lucklyduck/nailongBotWiki/source/docs/01-intro/01-specs.md

---
slug: /intro/specs
title: 规格参数
sidebar_label: 规格参数
---

import Electronics from '../_partials/materials-electronics.mdx';
import PrintedParts from '../_partials/materials-printed-parts.mdx';
import ServoAccessories from '../_partials/materials-servo-accessories.mdx';
import Tools from '../_partials/materials-tools.mdx';

## 1. 电子件

<Electronics />

## 2. 打印件

<PrintedParts />

## 3. 舵机配件

<ServoAccessories />

## 4. 工具

<Tools />
