lucklyduck/nailongBotWiki/source/README.md

# 奶龙机器人 Wiki 源码

用 Docusaurus 3 写成。打包说明和待确认清单见上一级目录的 README.md。

```bash
npm install
npm run start   # 边改边看
npm run build   # 正式构建，结果在 build/
./preview.sh    # 预览构建结果
```
