lucklyduck/nailongBotWiki/source/docs/all-docs.mdx

---
title: 全部文档
slug: /all-docs
hide_table_of_contents: true
sidebar_class_name: sidebar-hidden
sidebar_position: 100
---

import AllDocs from '@site/src/components/AllDocs';

<AllDocs />
