lucklyduck/nailongBotWiki/source/docs/01-intro/03-status.md

---
slug: /intro/status
title: 功能状态
sidebar_label: 功能状态
---

## 1. 功能适配表

✅ 支持　⚠️ 部分支持 / 有条件　❌ 不支持　— 不涉及

| 功能 | 官方 Otto 固件 v2.5.3 | 奶龙固件 2.0.16 | 说明 |
|---|---|---|---|
| 语音唤醒 | ✅ 你好小智 | ✅ 你好奶龙 | 奶龙唤醒词阈值 20%，识别率需实机调 |
| 按键对话 | ✅ | ✅ | 奶龙固件：待机时按一下进入对话，对话中按一下退出 |
| xiaozhi.me 对话 | ✅ | ✅ | |
| 屏幕表情 | ✅ 21 个 | ✅ 21 个看山表情 | 表情名称相同 |
| 动作贴图 | ❌ | ✅ | 动作时临时显示对应动作图 |
| 走路 / 转身 / 跳 / 摇摆 / 太空步 / 弯腰 / 抖腿 / 上下 | ✅ | ✅ | |
| 手臂动作 | ✅ 需装手臂 | ❌ | 奶龙不装手臂 |
| 奶龙大笑音效 `self.otto.laugh` | ❌ | ✅ | 本地播放约 2 秒笑声 |
| 舵机校准（语音） | ✅ | ✅ | `set_trim` / `get_trims` |
| 微信小程序控制 / 校准 | ✅（≥ v2.0.4-2） | ⚠️ 未验证 | |
| 网页在线烧录 | ✅ | ❌ | 奶龙固件需要自己编译 |
| 本地 Otto Master（局域网 MQTT / WebSocket） | ❌ | ✅ | 进阶，见 [本地联调](/docs/debug/otto-master) |
| 摄像头 | ⚠️ 摄像头版硬件 | ❌ | 奶龙外壳没有摄像头位置 |

## 2. 怎么选

- 只想尽快让它动起来：用 **官方固件**，[网页在线烧录](/docs/flash/online) 5 分钟搞定，然后换成奶龙人设也能聊。
- 想要「你好奶龙」唤醒、看山表情和奶龙大笑，或者打算改代码：用 **奶龙固件**，见 [编译奶龙固件](/docs/flash/build)。
