lucklyduck/nailongBotWiki/source/docs/05-xiaozhi/01-login.md

---
slug: /xiaozhi/login
title: 注册登录
sidebar_label: 注册登录
---

## 1. 登录

1. 用电脑或手机浏览器打开 [xiaozhi.me](https://xiaozhi.me/)。
2. 点击进入 **控制台**。
3. 用手机号和短信验证码登录。第一次登录会自动注册。

**会看到什么**：登录后进入控制台，首页是「智能体」列表。新账号会有一个默认智能体，或者需要先点「创建智能体」建一个。

## 2. 智能体是什么

**智能体**就是一个「角色」：它有自己的名字、人设、声音和大模型。一个智能体下可以绑定多台机器人，它们会共用同一套人设。

建议给奶龙单独建一个智能体，取名「奶龙」，之后在 [配置奶龙人设](/docs/xiaozhi/role) 里设置。

:::tip
有多只样机（比如奶龙和看山）时，可以建两个智能体，一个叫「奶龙」一个叫「看山」，分别绑定，就能有两种性格。
:::
