lucklyduck/nailongBotWiki/source/docs/05-xiaozhi/index.md

---
slug: /xiaozhi
title: xiaozhi 后台
sidebar_label: xiaozhi 后台
---

## 1. 简介

[xiaozhi.me](https://xiaozhi.me/) 是小智 AI 的官方后台。奶龙机器人自己只负责「听、说、动」，听懂你的话、按人设想好怎么回答、合成语音，都在这个后台完成。

在后台里你可以：

- 把机器人绑定到自己的账号
- 设置角色人设（让它说话像奶龙）
- 选择大模型、声音、对话语言
- 接入云端 MCP，给奶龙加新本领（查天气、控制智能家居等）

改完设置后**不用重新烧录**，重启机器人或者下一次对话就生效。

| 步骤 | 页面 |
|---|---|
| 1 | [注册登录](/docs/xiaozhi/login) |
| 2 | [绑定设备](/docs/xiaozhi/bind) |
| 3 | [配置奶龙人设](/docs/xiaozhi/role) |
| 进阶 | [接入云端 MCP](/docs/xiaozhi/mcp) |

:::info
xiaozhi.me 的界面会更新，本章的菜单名称以写作时（2026-10）为准。找不到某个按钮时，按意思在页面上找相近的入口。
:::

:::info 待补充
本章各步骤的后台真实截图。
:::

## 2. 机器人怎么找到后台

奶龙固件和官方固件开机后都会访问默认的 OTA 地址 `https://api.tenclass.net/xiaozhi/ota/`，这是 xiaozhi.me 的服务。后台会告诉机器人：该连哪个服务器、有没有新固件、有没有绑定账号。所以**不需要在机器人上做任何服务器设置**，配好网就能连上。

想换成自己搭的服务器，见 [更换服务端](/docs/dev/server)。
