lucklyduck/nailongBotWiki/source/docs/08-download/02-contact.md

---
slug: /download/contact
title: 联系与反馈
sidebar_label: 联系与反馈
---

## 1. 奶龙机器人

奶龙机器人由 **知造 ZhiForge**（catnipent 团队）在 2026 知乎黑客松 · 校园新锐季上制作。ZhiForge 想做的事是：把知乎上的硬件灵感、三维预览、代码生成和实机烧录接成一条线，让普通人「一句话 + 一根数据线」就能做出自己的 AI 硬件伙伴。奶龙就是这条线上做出来的第一只。

<figure>
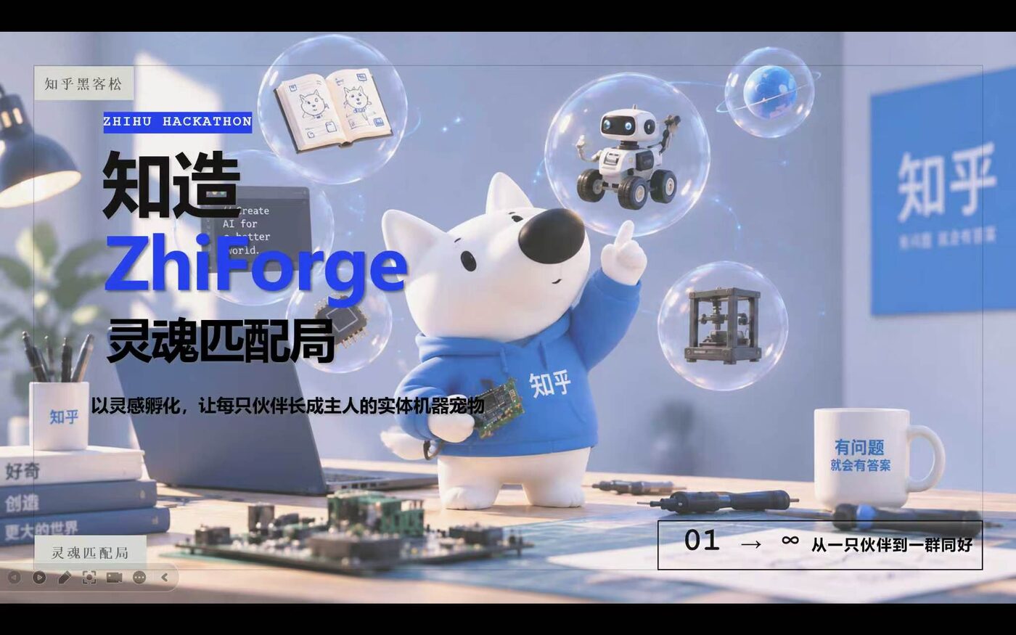
[picture p9: source/static/img/photos/zhiforge-cover.jpg]
知造 ZhiForge 灵魂匹配局的封面图：刘看山穿着知乎卫衣站在工作台前，周围漂浮着书本、机器人和 3D 打印机的气泡
  
  <figcaption>知造 ZhiForge · 灵魂匹配局</figcaption>
</figure>

<figure>
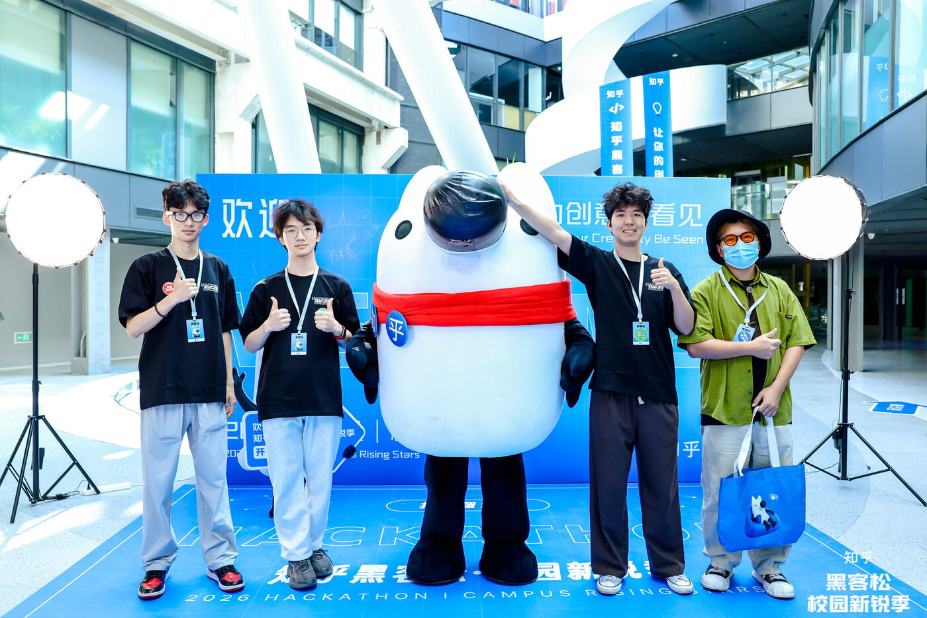
[picture p10: source/static/img/photos/team.jpg]
catnipent 团队成员和刘看山吉祥物在 2026 知乎黑客松背景板前合影
  
  <figcaption>catnipent 团队与刘看山</figcaption>
</figure>

<figure>
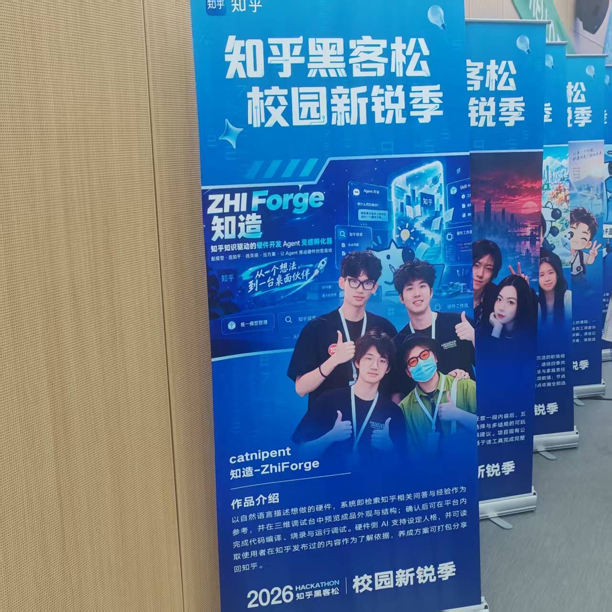
[picture p11: source/static/img/photos/rollup.jpg]
黑客松现场的易拉宝展架，写着知造 ZhiForge、catnipent 团队和作品介绍
  
  <figcaption>黑客松现场的作品展架</figcaption>
</figure>

:::info 待补充
团队的联系方式（知乎账号、邮箱或交流群）。
:::

## 2. Otto 社区

| 渠道 | 地址 |
|---|---|
| 立创开源工程（评论区） | [oshwhub.com/txp666/ottorobot](https://oshwhub.com/txp666/ottorobot) |
| Otto 复刻交流 QQ 群 | 1046432896 |
| Otto 官方文档 | [ottodiy.tech](https://ottodiy.tech/) |
| 闪猫侠官网 | [shanmaotech.cn](https://www.shanmaotech.cn/) |

## 3. 小智 AI

| 渠道 | 地址 |
|---|---|
| 源码与 Issues | [github.com/78/xiaozhi-esp32](https://github.com/78/xiaozhi-esp32) |
| 后台 | [xiaozhi.me](https://xiaozhi.me/) |

## 4. 反馈 wiki 的问题

发现步骤写错、链接失效，或者你照着做成功了想分享照片，都欢迎反馈。提问时附上：

1. 用的是官方固件还是奶龙固件，版本号
2. 卡在哪一页的哪一步
3. 串口日志（见 [看串口日志](/docs/debug/serial)）
