lucklyduck/nailongBotWiki/source/docs/08-download/03-share.md

---
slug: /download/share
title: 晒出你的奶龙
sidebar_label: 晒出你的奶龙
---

## 1. 为什么要晒

ZhiForge 想做的事情之一，就是让做出来的东西不止停在自己桌上。你从知乎上找到的灵感、踩过的坑，写出来就能变成下一个人的起点；大家围着同一只奶龙交流，它就会越做越好用。

> 你从知友那里得到了灵感，又把自己的尝试和经验留给知友。
> —— 摘自 ZhiForge 黑客松作品介绍

## 2. 发什么

一篇帖子不用很长，有下面几样就很好：

| 内容 | 例子 |
|---|---|
| 一张成品照 | 你的奶龙站在桌上的样子 |
| 一段 10～20 秒视频 | 说「你好奶龙，跳个舞」，它跳起来 |
| 你改了什么 | 换了颜色、新写了一个动作、改了人设 |
| 卡在哪、怎么解决的 | 「舵机插反了，棕线要朝外」 |
| 还没解决的问题 | 留给评论区一起想办法 |

## 3. 发到哪

| 地方 | 说明 |
|---|---|
| 知乎 | 发在「小智 AI」「ESP32」「DIY 机器人」「桌面宠物」等相关话题下，带上 `#ZhiForge` |
| Otto 复刻交流 QQ 群 | 1046432896，适合问具体技术问题 |
| 立创开源工程评论区 | [oshwhub.com/txp666/ottorobot](https://oshwhub.com/txp666/ottorobot)，给原作者反馈 |

:::info 待补充
奶龙机器人自己的交流群或知乎专栏。
:::

## 4. 发之前检查

- [ ] 视频和照片里没有家里的门牌、Wi-Fi 密码、xiaozhi.me 的 MCP 接入点地址
- [ ] 注明用到的开源项目：小智 AI、ottoRobot（CC BY-NC-SA 4.0，需署名）
- [ ] 奶龙形象只用于个人分享，不要拿去商用

:::nailong
做好了一定要发出来给大家看看！我想看到穿各种颜色衣服的奶龙站成一排。
:::
