lucklyduck/nailongBotWiki/source/docs/_partials/materials-electronics.mdx

<div className="purchase-table" role="region" aria-label="电子件、购买链接与参考价，可横向滚动" tabIndex={0}>

| # | 名称 | 型号 / 规格 | 数量 | 备注 | 购买链接 | <span title="2026-11-13 商品页记录，不含另计运费；优惠价以结算时为准">参考价</span> |
| --- | --- | --- | --- | --- | --- | --- |
| 1 | 主板 PCB | 立创开源 [ottoRobot V1.1](https://pro.lceda.cn/editor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) | 1 | 按实际工程版本在立创下单 | [立创工程与打板入口][pcb-order] | 按打板订单计价 |
| 2 | 主控模组 | ESP32-S3-WROOM-1U-**N16R8** | 1 | 必须是 16 MB Flash + 8 MB PSRAM。1U 是外接天线版，要配 IPEX 天线；板载天线的 -1 版也能用。推荐乐鑫原厂；天线候选的接口代际和线长待核对 | [乐鑫 N16R8 模组](https://item.taobao.com/item.htm?id=669879816972&skuId=5928281003813)<br/>[2.4GHz IPEX 天线](https://detail.tmall.com/item.htm?id=1036822881394) | 模组 ¥33/个<br/>天线 ¥6.98/根 |
| 3 | 舵机 | SG90 9g 180° | **4** | 建议多备 1 个；金属齿更耐用。链接选 SG90 180°、带小 5 孔配件 | [奥克欧 SG90](https://detail.tmall.com/item.htm?id=1077417446369&skuId=6294440894121) | ¥23.9/个（4个 ¥95.60） |
| 4 | 屏幕 | 1.54 寸 240×240 SPI（ST7789） | 1 | 链接选京东方玻璃胶框裸屏，不要选玻璃胶铁一体款 | [中景园屏幕](https://item.taobao.com/item.htm?id=600653923469&skuId=4193330464745) | ¥7.9/块 |
| 5 | 功放 | MAX98357AETE+T | 1 | 建议立创货。有人反馈淘宝货喇叭噪音大、发热、掉电快。链接为 TQFN-16 裸芯片，不是功放模块 | [佳信源功放芯片](https://item.taobao.com/item.htm?id=656824352017&skuId=4740462420725) | ¥6.97/颗 |
| 6 | 麦克风 | ICS-43434 | 1 | 选择 ICS-43434，不要误选同页 ZTS6672。INMP441 模块需按主板方案适配 | [启天芯云 ICS-43434](https://item.taobao.com/item.htm?id=1027088727329&skuId=6274228647907) | ¥30/颗 |
| 7 | 充电芯片 | TP4054 | 1 | 链接选 TP4054-42-SOT25R、SOT-23-5 | [佳信源 TP4054](https://item.taobao.com/item.htm?id=684690901003&skuId=5068394135896) | ¥1.28/颗 |
| 8 | 稳压 | HE9073A33M5R（3.3 V） | 1 | 选择 3.3 V、SOT-23-5 | [凌芯稳压芯片](https://item.taobao.com/item.htm?id=1039420678320) | ¥2.7/颗 |
| 9 | 喇叭 | 2828 4Ω 3W，1.25 mm 端子 | 1 | 选择 4R3W、2P1.25 银色款 | [芯创力喇叭](https://item.taobao.com/item.htm?id=939688934199&skuId=5836086884093)<br/>[兴华鑫喇叭（备选）](https://item.taobao.com/item.htm?id=857879179989&skuId=5670264693293) | 芯创力 ¥7.5/个<br/>兴华鑫 ¥3.7/个 |
| 10 | 电池 | 103450 2000 mAh（1.25 端子）或双 18650 包 3.7 V（PH2.0） | 1 | 两种方案选一种。确认红黑线、插头和极性与主板一致；103450 链接的端子待确认，18650 候选的双电芯结构待确认 | [103450 2000mAh](https://detail.tmall.com/item.htm?id=638394813102&skuId=4890126332973)<br/>[倍量 18650 PH 接口](https://detail.tmall.com/item.htm?id=734363822390) | 103450 ¥23.8/块<br/>18650 ¥10.9/组 |
| 11 | 电源开关 | XKB5858-Z-E 拨动开关 | 1 | 主链接为指定型号；备选为 5.8×5.8 侧插 6 脚自锁通用款，焊盘和尺寸待核对 | [XKB5858-Z-E](https://item.taobao.com/item.htm?id=781094702611)<br/>[思诚达通用款](https://detail.tmall.com/item.htm?id=631520524805&skuId=4680509671372) | XKB ¥2.47/个<br/>通用款 ¥0.24/个 |
| 12 | 功能键 | TS35CA 轻触按键 | 1 | 有的店铺清单里叫 BOOT 键，立创一键下单可能不含，需要单独买。链接为 3.3×4.5×6H 通用候选，非已确认的 TS35CA 原品牌，需核对按键高度和脚位 | [温州跃一 BOOT 按键](https://item.taobao.com/item.htm?id=619380317760&skuId=4915088025515) | ¥0.16/只 |
| 13 | 舵机排针 | 2.54 mm 2×3P（PZ254-2-03-S） | 2 | 原板有 3 组，第 3 组接手臂，奶龙可以不焊；链接选 2×3P，焊盘形式待核对 | [2.54mm 2×3P 排针](https://item.taobao.com/item.htm?id=700748964957&skuId=5120840371371) | ¥0.08/个 |
| 14 | 接口座 | HC-1.25 2P（喇叭）、PH2.0 2P（电池） | 各 1 | 喇叭座 10 只/包，电池座 20 只/包；均为立贴候选，核对 PCB 焊盘及电池插头，不能仅按间距混用 | [1.25mm 2P 喇叭座](https://item.taobao.com/item.htm?id=528734911747&skuId=4981522281625)<br/>[PH2.0 2P 电池座](https://item.taobao.com/item.htm?id=676352225666&skuId=4862819477391) | 喇叭座 ¥1.76/10只<br/>电池座 ¥1.5/20只 |
| 15 | 阻容等 | 见立创 BOM | — | 按最终 BOM 的数值、封装和用量下单 | [立创工程与 BOM 入口][pcb-order] | 按 BOM 计价 |

</div>

[pcb-order]: https://pro.lceda.cn/editor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
