lucklyduck/nailongBotWiki/source/docs/_partials/materials-printed-parts.mdx

Wiki中有全套开源外壳可自行下载打印

<div className="purchase-table" role="region" aria-label="打印件与购买链接，可横向滚动" tabIndex={0}>

| 零件 | 数量 | 本站模型下载 | 购买链接 |
|---|---|---|---|
| 身体外壳 | 1 | <a href="/downloads/models/2026-11-13/01-shell.stl" download="01-shell.stl">01_奶蛙外壳.stl</a> | [3D 代打印询价][print-order] |
| 无手臂机身底座 | 1 | <a href="/downloads/models/2026-11-13/02-body-no-arms.stl" download="02-body-no-arms.stl">02_店家无手body.stl</a> | [3D 代打印询价][print-order] |
| 右卡销 | 1 | <a href="/downloads/models/2026-11-13/03-right-pin.stl" download="03-right-pin.stl">03_右卡销.stl</a> | [3D 代打印询价][print-order] |
| 左卡销 | 1 | <a href="/downloads/models/2026-11-13/04-left-pin.stl" download="04-left-pin.stl">04_左卡销.stl</a> | [3D 代打印询价][print-order] |
| 右腿 | 1 | <a href="/downloads/models/2026-11-13/05-right-leg.stl" download="05-right-leg.stl">05_右腿.stl</a> | [3D 代打印询价][print-order] |
| 左腿 | 1 | <a href="/downloads/models/2026-11-13/06-left-leg.stl" download="06-left-leg.stl">06_左腿.stl</a> | [3D 代打印询价][print-order] |
| 左脚 | 1 | <a href="/downloads/models/2026-11-13/07-left-foot.stl" download="07-left-foot.stl">07_左脚.stl</a> | [3D 代打印询价][print-order] |
| 右脚 | 1 | <a href="/downloads/models/2026-11-13/08-right-foot.stl" download="08-right-foot.stl">08_右脚.stl</a> | [3D 代打印询价][print-order] |

</div>

[print-order]: https://detail.tmall.com/item.htm?id=1062649997018

八个 STL 各打印 1 件。外壳原文件名为 `01_奶蛙外壳.stl`；3MF 是含外壳、底座与左右卡销的四对象参考工程，不计入额外打印数量。不要混用旧版模型；打印参数和试装说明见 [打印外壳](/docs/assembly/print)。

代打印链接是待询价的服务候选，尚未核验这套模型的具体报价；需要提供 STL、材料、颜色和数量，店铺展示价不代表整套打印费用。
