lucklyduck/nailongBotWiki/source/docs/_partials/materials-servo-accessories.mdx

舵机包里自带，别扔：

- 十字摇臂：装腿用，要剪短
- 脚部专用形状的摇臂：装脚用
- 两颗大螺丝：把舵机固定到机身上
- 小螺丝：固定摇臂
