lucklyduck/nailongBotWiki/site/downloads/models/2026-11-13/01-shell.stl

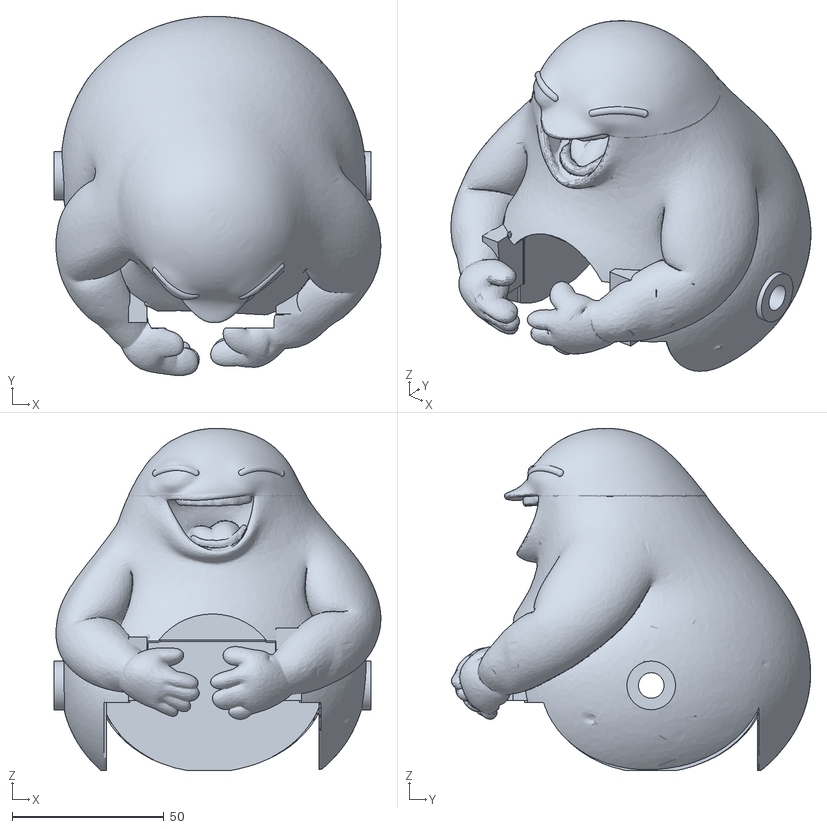
[picture p16: CAD file, 2026-11-12]
site/downloads/models/2026-11-13/01-shell.stl
107.6 x 118.3 x 112.6
