lucklyduck/nailongBotWiki/site/downloads/nailong-shell.stl

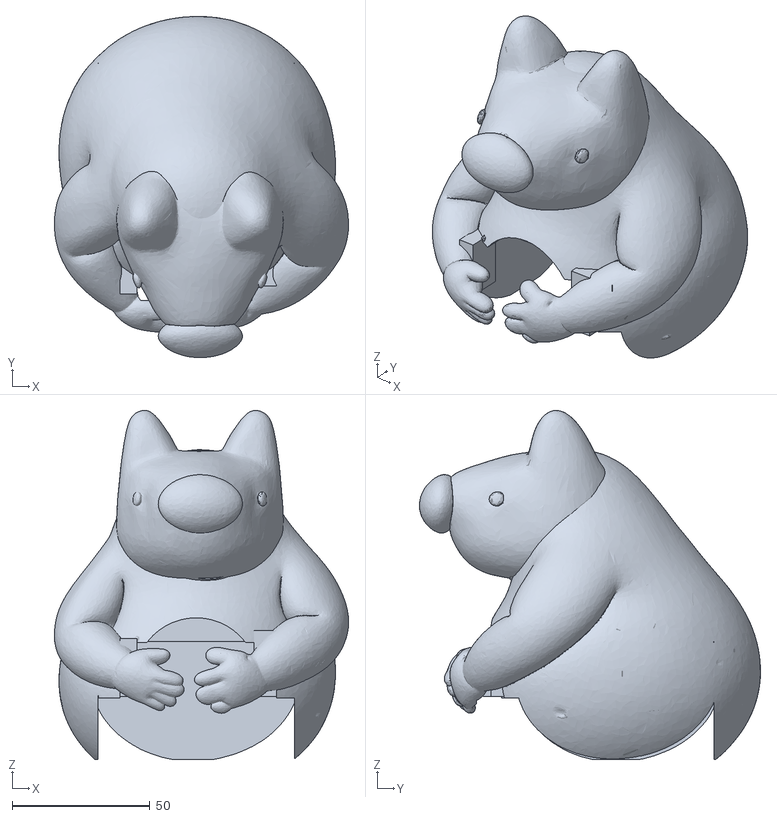
[picture p17: CAD file, 2026-11-03]
site/downloads/nailong-shell.stl
107.0 x 124.0 x 127.0
