lucklyduck/nailongBotWiki/source/static/downloads/models/2026-11-13/07-left-foot.stl

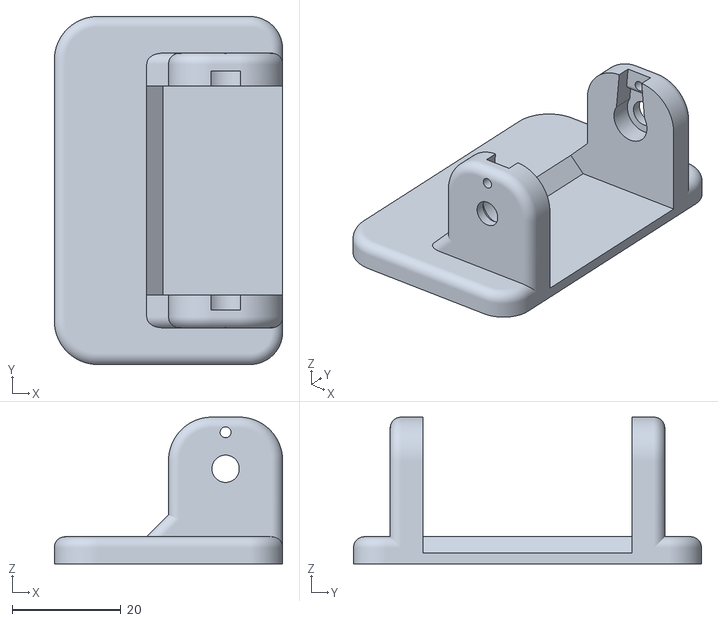
[picture p18: CAD file, 2026-11-12]
source/static/downloads/models/2026-11-13/07-left-foot.stl
42.0 x 64.0 x 27.0
