lucklyduck/nailongBotWiki/source/static/downloads/models/2026-11-13/04-left-pin.stl

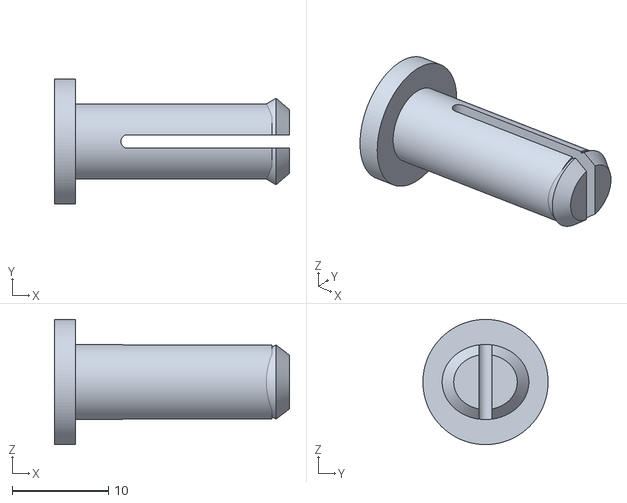
[picture p19: CAD file, 2026-11-12]
source/static/downloads/models/2026-11-13/04-left-pin.stl
24.4 x 13.0 x 13.0
