lucklyduck/nailongBotWiki/source/static/downloads/models/2026-11-13/06-left-leg.stl

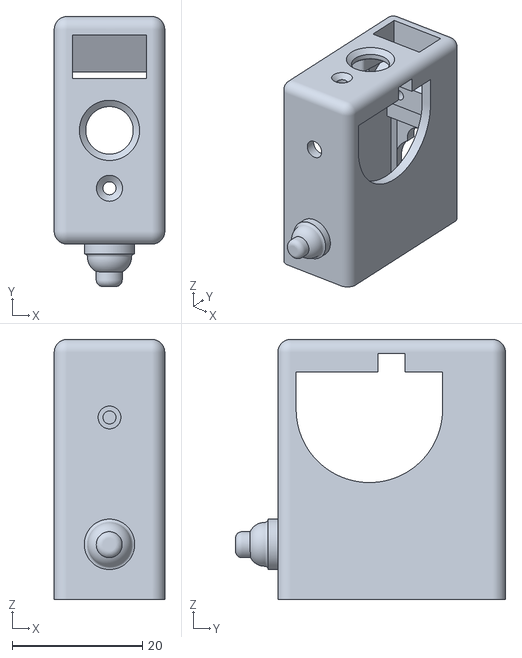
[picture p20: CAD file, 2026-11-12]
source/static/downloads/models/2026-11-13/06-left-leg.stl
17.0 x 41.5 x 40.0
