lucklyduck/nailongBotWiki/source/static/downloads/models/2026-11-13/reference-project.3mf

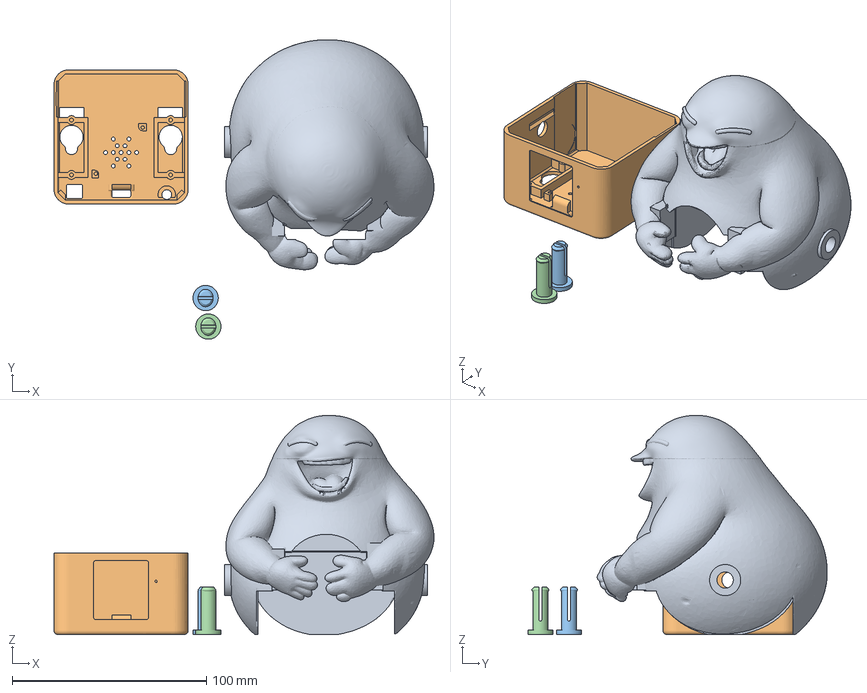
[picture p21: CAD file, 2026-11-12]
source/static/downloads/models/2026-11-13/reference-project.3mf
195.4 x 154.0 x 112.6 mm
01_奶蛙外壳.stl
02_店家无手body.stl
03_右卡销.stl
04_左卡销.stl
