lucklyduck/nailongBotWiki/source/static/downloads/models/2026-11-13/02-body-no-arms.stl

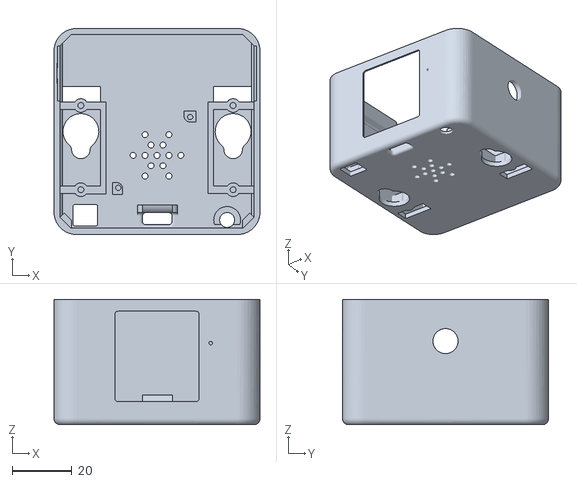
[picture p22: CAD file, 2026-11-12]
source/static/downloads/models/2026-11-13/02-body-no-arms.stl
69.0 x 69.0 x 42.0
