lucklyduck/nailongBotWiki/(list of files, cad)

Other CAD files:
site/downloads/models/2026-11-13/08-right-foot.stl
site/downloads/models/2026-11-13/03-right-pin.stl
source/static/downloads/models/2026-11-13/05-right-leg.stl
site/downloads/models/2026-11-13/05-right-leg.stl
source/static/downloads/models/2026-11-13/03-right-pin.stl
source/static/downloads/models/2026-11-13/08-right-foot.stl
