lucklyduck/nailongBotWiki/source/docs/02-assembly/01-prepare.md

---
slug: /assembly/prepare
title: 物料与工具
sidebar_label: 物料与工具
---

import Electronics from '../_partials/materials-electronics.mdx';
import PrintedParts from '../_partials/materials-printed-parts.mdx';
import ServoAccessories from '../_partials/materials-servo-accessories.mdx';
import Tools from '../_partials/materials-tools.mdx';

## 1. 两种备料方式

| 方式 | 你需要准备 | 适合 |
|---|---|---|
| **买套件** | 由我们提供完整的零部件套装 | 第一次做，想快点看到成品 |
| **自己买料** | 下面所有电子件 + 自己打 PCB、焊接 + 打印全部结构件 | 想完整体验一遍，或者想改电路 |

套件购买入口见 ottodiy.tech 的 [零部件清单](https://ottodiy.tech/docs/bom)。注意套件通常包含**手臂**（6 个舵机），奶龙只用 4 个。

<figure>
  奶龙需要的八组零件：奶龙外壳、无手臂机身底座、两条腿、两只脚、四个 SG90 舵机、主板和 1.54 寸屏、电池和喇叭、摇臂螺丝和天线
  <figcaption>开工前把这些摆在桌上（示意图）</figcaption>
</figure>

<figure>
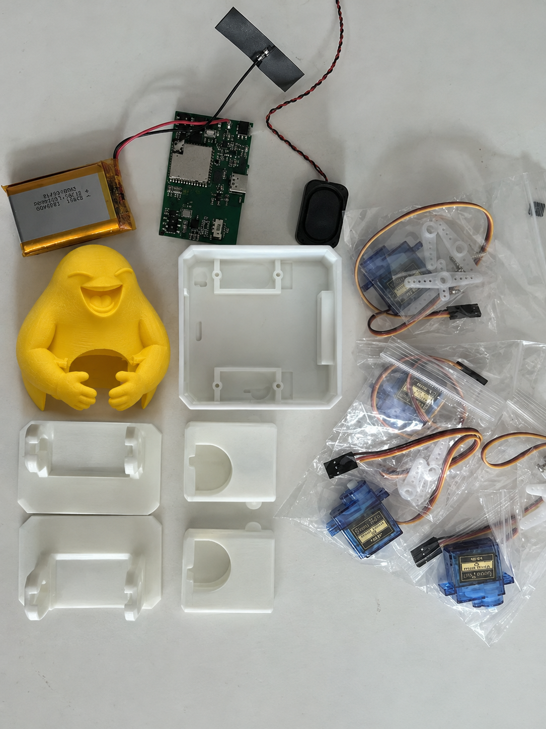
[picture p23: source/static/img/assembly/parts-yellow-shell-20261113.png]
配件示意图：黄色身体外壳与白色底座、腿脚摆在桌面，旁边保留锂电池、主板、天线、喇叭及四个蓝色舵机
  
  <figcaption>配件示意图：依据本套 STL 替换为黄色上半身外壳，保留原图电子件（基于 ottodiy.tech 组装教程图 1 编辑，非整套实拍；零件数量以清单为准）</figcaption>
</figure>

## 2. 电子件

<Electronics />

## 3. 打印件

<PrintedParts />

## 4. 舵机配件

<ServoAccessories />

## 5. 工具

<Tools />
