lucklyduck/nailongBotWiki/site/docs/assembly/legs/index.html

跳到主要内容

本页总览

# 装腿和脚

本页使用当前模型包中的 右腿、左腿、左脚、右脚，各 1 件。底座及左右卡销也请使用 同一套模型，不要混用旧版零件。

## 1. 装腿（对应视频 P3）

B 站组装教程 P3：腿部安装，10 分 32 秒（鹿小班电子科技，打不开就点这里去 B 站看 (https://www.bilibili.com/video/BV1zuNyzXEWa?p=3)）

关于下面的步骤图

标「渲染图」的来自 ottodiy.tech 的 Otto 原版组装教程，颜色和奶龙样机不一样（原版是灰色身体、粉色脚），这些图用于理解装配顺序；当前模型的孔位、配合和左右方向请以下载文件及试装结果为准。

修剪十字摇臂：剪之前在长的两端红线处剪，剪之后变短，能塞进腿部零件的槽里

十字摇臂剪短前后（示意图）

装腿三步：两颗大螺丝把舵机固定到机身底座，剪好的摇臂嵌进腿里，腿垂直套到舵机轴上拧中间螺丝

装腿三步（示意图）

1. 用舵机包里的两颗大螺丝，把两个腿舵机固定到机身底座上。
2. 修剪十字摇臂：用斜口钳把较长的两端各剪掉一半左右。
3. 把十字摇臂装进腿部零件。
4. 把腿装到舵机输出轴上，注意方向：

从上往下看腿的方向：正确是两条腿平行朝前，腿上的圆柱凸起朝屏幕一侧；错误的两种是内八和外八；轻微偏差可以用软件校准

两腿平行朝前，圆柱凸起朝屏幕一侧（示意图）

- 腿上的圆柱凸起朝屏幕一侧
- 腿垂直朝前，不要内八或外八。差一点点没关系，后面可以 软件校准
5. 拧上摇臂中间的固定螺丝。

渲染图：用螺丝刀把腿部舵机从侧面固定进机身底座

① 用两颗大螺丝固定腿舵机（图 3）

渲染图：俯视机身底座，左右两个腿舵机已经装好

② 两个腿舵机装好后的样子（图 4）

渲染图：十字摇臂较长的两端被剪短

③ 剪短十字摇臂（图 5）

渲染图：剪好的十字摇臂嵌进腿部零件的槽里

④ 摇臂嵌进腿里（图 6）

渲染图：两条腿从下方套到机身底座的舵机轴上，拧中间螺丝

⑤ 腿套上舵机轴，拧中间螺丝（图 7）

以上渲染图来源：ottodiy.tech 组装教程 第 3 步。

## 2. 装脚（对应视频 P4）

B 站组装教程 P4：组装脚部，7 分 08 秒（鹿小班电子科技，打不开就点这里去 B 站看 (https://www.bilibili.com/video/BV1zuNyzXEWa?p=4)）

装脚三步：脚摇臂竖直朝上装在脚上，脚舵机装进腿的下端、线往上穿，脚套到舵机轴上拧固定螺丝

装脚三步（示意图）

1. 用脚部专用形状的摇臂，垂直朝上装到脚上，拧紧螺丝。
2. 把脚舵机装进脚里，舵机线从腿里穿进身体。
3. 把脚装到腿上，拧上舵机固定螺丝。

渲染图：脚舵机装上单边摇臂并拧紧螺丝

① 脚舵机装上专用摇臂（图 8）

渲染图：两个脚舵机装进脚掌支架

② 舵机装进脚里（图 9）

渲染图：标注「舵机线先穿到身体内」，脚舵机的线向上穿过腿进入身体

③ 舵机线先穿进身体（图 10）

渲染图：脚部组件从下往上对准腿插进去

④ 脚对准腿插上（图 11）

渲染图：用螺丝刀从侧面拧紧脚舵机的固定螺丝

⑤ 侧面拧紧固定螺丝（图 12）

以上渲染图来源：ottodiy.tech 组装教程 第 4 步。

## 3. 检查

奶龙下半身特写：两条白色的腿竖直平行，两只蓝色的脚平放在地板上

装好的腿和脚应该是这样：腿竖直平行、脚放平（截自演示视频）

- 两条腿竖直、互相平行
- 两只脚平放在桌面上
- 舵机线都穿进了身体，没有被夹住

 奶龙说

差几度没关系，后面我可以自己「校准」。但要是差了半个齿以上，最好拆下摇臂重新对一次，软件只能救 ±50°。

- 1. 装腿（对应视频 P3）
- 2. 装脚（对应视频 P4）
- 3. 检查

文档

- 产品介绍
- 组装
- 全部文档

资料

- ottodiy.tech (https://ottodiy.tech/docs/downloads/)
- ottoRobot (https://github.com/txp666/ottodiy-docs)
- xiaozhi.me

交流

- FAQ
- 更新日志

知造 ZhiForge · 2026 知乎黑客松 · 文档 © 2026 奶龙机器人项目
