lucklyduck/nailongBotWiki/source/docs/08-download/01-changelog.md

---
slug: /download/changelog
title: 更新日志
sidebar_label: 更新日志
---

## 1. 奶龙固件

| 版本 | 内容 |
|---|---|
| 2.0.16 | MQTT 重连也走显式 mDNS 解析 `master.local`，换路由器或换电脑不用改固件 |
| 2.0.15 | Otto Master 可以远程进入 / 退出循环对话；先回 ACK 再切换音频通道 |
| 2.0.14 | 动作贴图跟随实际动作任务开始 / 结束；状态查询返回当前贴图、音效、音量 |
| 2.0.13 | 音量迁移到 100（只迁移一次，之后保留用户设置） |
| 2.0.12 | 圆屏表情换成看山贴图（21 个表情 + 动作贴图）；音量 90；动作任务优先级低于音频 |
| 2.0.11 | 按键会话开关：待机按一下进入循环对话，对话中按一下退出 |
| 2.0.8 | 诊断用 `voice_wake`（需要设备 token） |
| 2.0.7 | 支持 WebSocket Profile 和 `preferred_transport` 切换 |
| — | 「你好奶龙」自定义唤醒词、`self.otto.laugh` 奶龙大笑、四舵机无手臂配置 |

## 2. 官方 Otto 固件

| 版本 | 日期 | 内容 |
|---|---|---|
| v2.5.3 | 2026-10-19 | 更新到小智 2.5.3；21 个表情重新绘制 |
| v2.4.2 | 2026-08-27 | 更新到小智 2.4.2 |
| v2.3.0 | 2026-07-16 | 表情增加到 21 个 |
| v2.2.6 | 2026-05-18 | 动作收尾更平滑；修复 WebSocket 直连收不到 MCP 响应 |
| v2.0.4-2 | 2025-11-17 | 增加微信小程序控制 / 校准 / 自定义 |
| v2.0.4 | 2025-10-31 | 更新到小智 2.0.4；固定动作和 AI 自定义编程动作 |
| v1.4.4 | 2025-06-13 | 新增初始位置校准 |

完整列表见 [ottodiy.tech 下载页](https://ottodiy.tech/docs/downloads/)。

## 3. 本 wiki

| 日期 | 内容 |
|---|---|
| 2026-10-24 | 参考 Datawhale 鲸鱼小车课程，新增「学习路线」（Task 0～5）和「晒出你的奶龙」 |
| 2026-10-24 | 第一版：产品介绍、组装、烧录、调试、xiaozhi 后台、二次开发、FAQ、下载 |
