lucklyduck/nailongBotWiki/site/docs/faq/index.html

跳到主要内容

本页总览

# FAQ

按主题分组。每条都是「现象 → 原因 → 解决」，找不到的话用右上角搜索，或者去对应章节的「常见问题」。

## 1. 关于这个项目

### 1.1 奶龙机器人和 Otto 是什么关系？

奶龙机器人就是一台 小智 AI Otto (https://oshwhub.com/txp666/ottorobot)：电路、腿脚结构、固件框架都来自 Otto 开源项目。ZhiForge 换了奶龙 / 看山造型的身体外壳，并在固件里加了「你好奶龙」唤醒词、看山表情和奶龙大笑。

### 1.2 为什么有两种固件？

官方 Otto 固件一键就能烧，适合先跑起来；奶龙固件是在黑客松上为奶龙定制的，需要自己编译。区别见 功能状态。

## 2. 组装

### 2.1 舵机不转

棕线（GND）是不是朝外？电池有没有电？固件烧了没有？三个都确认过还不转，换一个舵机试试。见 装完自检。

### 2.2 走路歪、站不直

摇臂装偏了。小偏差用 舵机校准；偏得多就拆下摇臂，重新 归中 后再装。

### 2.3 语音让它做动作，经常摔倒

一只机器人在走路时侧身摔倒在木地板上

演示时也摔过（截自演示视频）

动作幅度和速度太大，或者站姿没校准。先校准，再在 人设 里少用跳跃、太空步这类大动作，或者让大模型用小一点的 amount 和大一点的 speed。

## 3. 烧录

### 3.1 电脑找不到串口

换一根能传数据的 Type-C 线，换 USB 口。见 烧录前检查。

### 3.2 Failed to connect

手动进下载模式：按住功能键（BOOT）再开机。见 进入下载模式。

### 3.3 烧到一半失败

降低波特率（921600 → 115200）重试，确认电池有电。

### 3.4 烧完奶龙固件，「你好奶龙」叫不醒

只烧了主程序，没烧唤醒词模型。用完整的 idf.py flash。见 编译奶龙固件。

## 4. 网络和后台

### 4.1 找不到自家 Wi-Fi

ESP32-S3 只支持 2.4 GHz。打开路由器的 2.4 GHz，或者用手机开热点。见 配网。

### 4.2 没听清验证码 / 验证码无效

看屏幕，或重启机器人重新获取。见 绑定设备。

### 4.3 能聊天但不做动作

大模型没调用动作工具。在人设里点名工具（例如「让我笑的时候调用 self.otto.laugh」），并选支持工具调用的模型。见 配置奶龙人设。

### 4.4 声音太嗲，想换

在 xiaozhi.me 的角色配置里换一个 角色音色，保存后重启。

## 5. 使用

### 5.1 电量显示忽高忽低

做大幅度动作时电压会下降，电量显示跟着变低，属于正常现象。以静止时的显示为准，及时充电。

### 5.2 喇叭噪音大、功放发烫

可能是功放芯片质量问题。有人反馈淘宝买的 MAX98357A 有这个现象，换立创的器件后解决。

### 5.3 同音字经常听错

语音识别在云端完成，靠近一点、说慢一点会好些；也可以在人设里写「听不懂就大笑」，至少场面不尴尬。

 奶龙说

还有问题？先看 串口日志，十个问题里有八个日志里写得清清楚楚。剩下两个去 联系与反馈 找人问问。

- 1. 关于这个项目
  - 1.1 奶龙机器人和 Otto 是什么关系？
  - 1.2 为什么有两种固件？
- 2. 组装
  - 2.1 舵机不转
  - 2.2 走路歪、站不直
  - 2.3 语音让它做动作，经常摔倒
- 3. 烧录
  - 3.1 电脑找不到串口
  - 3.2 Failed to connect
  - 3.3 烧到一半失败
  - 3.4 烧完奶龙固件，「你好奶龙」叫不醒
- 4. 网络和后台
  - 4.1 找不到自家 Wi-Fi
  - 4.2 没听清验证码 / 验证码无效
  - 4.3 能聊天但不做动作
  - 4.4 声音太嗲，想换
- 5. 使用
  - 5.1 电量显示忽高忽低
  - 5.2 喇叭噪音大、功放发烫
  - 5.3 同音字经常听错

文档

- 产品介绍
- 组装
- 全部文档

资料

- ottodiy.tech (https://ottodiy.tech/docs/downloads/)
- ottoRobot (https://github.com/txp666/ottodiy-docs)
- xiaozhi.me

交流

- FAQ
- 更新日志

知造 ZhiForge · 2026 知乎黑客松 · 文档 © 2026 奶龙机器人项目
