lucklyduck/nailongBotWiki/site/docs/debug/voice/index.html

跳到主要内容

本页总览

# 唤醒与声音

## 1. 简介

这一页讲怎么和奶龙开始对话、怎么调音量，以及唤醒不灵时怎么排查。

## 2. 开始和结束对话

方式 | 奶龙固件 | 官方固件
说唤醒词 | 「你好奶龙」 | 「你好小智」
按功能键（身体下方右侧） | 待机时按一下进入对话；连接中、听你说话或正在回答时再按一下，退出到待机 | 按一下开始对话 / 打断
自动结束 | 一段时间没人说话后回到待机 | 同左

对话中机器人执行动作时，你仍然可以说话，比如说「停下」让它立刻停止。

奶龙和看山屏幕亮起，显示表情，正在对话

对话时屏幕会显示表情和字幕（截自演示视频）

## 3. 能说什么

类别 | 例子
聊天 | 「你是谁？」「讲个笑话」
走路 | 「向前走」「向前走五步，快一点」「后退」「左转」「右转」
动作 | 「跳一下」「摇摆」「跳个舞」「太空步」「弯弯腰」「抖抖腿」「上下蹲」
奶龙专属 | 「笑一个」→ 播放约 2 秒奶龙大笑
停止 | 「停下」「停止」
设备 | 「音量调大一点」「还有多少电？」
校准 | 「把左脚校准到 10 度」

动作的完整参数见 二次开发 · 源码结构。

 奶龙说

叫我「你好奶龙」，四个字说清楚。叫「奶龙奶龙」我是不理的哦，嘿嘿。

## 4. 音量

奶龙固件第一次启动时会把音量设为 100（最大）。之后你用语音调过的音量会被保存，重启不会被覆盖。

## 5. 唤醒不灵怎么办

奶龙固件的唤醒词是用乐鑫 MultiNet 中文命令词模型做的自定义唤醒词，拼音 ni hao nai long，初始阈值 20%。

现象 | 原因 | 解决
说了没反应 | 环境太吵 / 离得太远 | 靠近一点、说清楚一点；或者按 BOOT 键代替
完全唤醒不了 | 只烧了主程序，没烧唤醒词模型 | 用完整的 idf.py flash 重烧，见 编译奶龙固件
经常误唤醒 | 阈值太低 | 在 menuconfig 里调高阈值，见 修改唤醒词
唤醒了但不说话 | 没联网 / 没绑定 | 看屏幕状态栏，或 看串口日志
声音小、破音 | 喇叭没接好 / 电量低 | 检查喇叭插头，充电

待补充

「你好奶龙」在不同环境下的实测识别率、推荐阈值。

- 1. 简介
- 2. 开始和结束对话
- 3. 能说什么
- 4. 音量
- 5. 唤醒不灵怎么办

文档

- 产品介绍
- 组装
- 全部文档

资料

- ottodiy.tech (https://ottodiy.tech/docs/downloads/)
- ottoRobot (https://github.com/txp666/ottodiy-docs)
- xiaozhi.me

交流

- FAQ
- 更新日志

知造 ZhiForge · 2026 知乎黑客松 · 文档 © 2026 奶龙机器人项目
