lucklyduck/nailongBotWiki/site/assets/js/0e166e94.742548a9.js

"use strict";(globalThis.webpackChunkwiki_site||=[]).push([[3207],{2546(d,s,e){e.r(s),e.d(s,{assets:()=>c,contentTitle:()=>l,default:()=>j,frontMatter:()=>i,metadata:()=>n,toc:()=>h});const n=JSON.parse('{"id":"intro/parts","title":"\u90e8\u4ef6\u4e0e\u5f15\u811a","description":"1. \u5916\u89c2","source":"@site/docs/01-intro/02-parts.md","sourceDirName":"01-intro","slug":"/intro/parts","permalink":"/docs/intro/parts","draft":false,"unlisted":false,"tags":[],"version":"current","sidebarPosition":2,"frontMatter":{"slug":"/intro/parts","title":"\u90e8\u4ef6\u4e0e\u5f15\u811a","sidebar_label":"\u90e8\u4ef6\u4e0e\u5f15\u811a"},"sidebar":"docs","previous":{"title":"\u89c4\u683c\u53c2\u6570","permalink":"/docs/intro/specs"},"next":{"title":"\u529f\u80fd\u72b6\u6001","permalink":"/docs/intro/status"}}');var r=e(5272),t=e(107);const i={slug:"/intro/parts",title:"\u90e8\u4ef6\u4e0e\u5f15\u811a",sidebar_label:"\u90e8\u4ef6\u4e0e\u5f15\u811a"},l=void 0,c={},h=[{value:"1. \u5916\u89c2",id:"1-\u5916\u89c2",level:2},{value:"2. \u5f15\u811a\u5206\u914d",id:"2-\u5f15\u811a\u5206\u914d",level:2},{value:"2.1 \u8235\u673a",id:"21-\u8235\u673a",level:3},{value:"2.2 \u97f3\u9891",id:"22-\u97f3\u9891",level:3},{value:"2.3 \u5c4f\u5e55",id:"23-\u5c4f\u5e55",level:3},{value:"2.4 \u7535\u6e90\u548c\u6309\u952e",id:"24-\u7535\u6e90\u548c\u6309\u952e",level:3},{value:"3. \u4e3b\u677f",id:"3-\u4e3b\u677f",level:2}];function x(d){const s={a:"a",admonition:"admonition",code:"code",h2:"h2",h3:"h3",p:"p",strong:"strong",table:"table",tbody:"tbody",td:"td",th:"th",thead:"thead",tr:"tr",...(0,t.R)(),...d.components};return(0,r.jsxs)(r.Fragment,{children:[(0,r.jsx)(s.h2,{id:"1-\u5916\u89c2",children:"1. \u5916\u89c2"}),"\n",(0,r.jsxs)(s.p,{children:["\u9700\u8981\u6253\u5370\u5916\u58f3\u3001\u5e95\u5ea7\u3001\u5de6\u53f3\u5361\u9500\u3001\u817f\u548c\u811a\u65f6\uff0c\u8bf7\u4f7f\u7528 ",(0,r.jsx)(s.a,{href:"/docs/assembly/print",children:"\u5f53\u524d\u516b\u4ef6\u6a21\u578b\u6e05\u5355"}),"\uff0c\u6bcf\u4e2a STL \u5404 1 \u4ef6\u3002"]}),"\n",(0,r.jsxs)("figure",{children:[(0,r.jsx)("img",{src:"/img/demo/nailong-front.jpg",alt:"\u9ec4\u8272\u5976\u9f99\u6b63\u9762\uff1a\u5f20\u5634\u5927\u7b11\uff0c\u53cc\u624b\u62b1\u7740\u80f8\u524d\u7684\u5c4f\u5e55\uff0c\u4e0b\u9762\u662f\u767d\u8272\u7684\u817f\u548c\u84dd\u8272\u7684\u811a"}),(0,r.jsx)("figcaption",{children:"\u5976\u9f99\u6b63\u9762\uff1a\u5c4f\u5e55\u5728\u80f8\u53e3\uff0c\u4e0b\u9762\u662f\u4e24\u6761\u817f\u548c\u4e24\u53ea\u811a\uff08\u622a\u81ea\u6f14\u793a\u89c6\u9891\uff09"})]}),"\n",(0,r.jsxs)(s.table,{children:[(0,r.jsx)(s.thead,{children:(0,r.jsxs)(s.tr,{children:[(0,r.jsx)(s.th,{children:"\u90e8\u4ef6"}),(0,r.jsx)(s.th,{children:"\u4f4d\u7f6e"}),(0,r.jsx)(s.th,{children:"\u8bf4\u660e"})]})}),(0,r.jsxs)(s.tbody,{children:[(0,r.jsxs)(s.tr,{children:[(0,r.jsx)(s.td,{children:"\u5706\u5c4f"}),(0,r.jsx)(s.td,{children:"\u80f8\u53e3\uff0c\u88ab\u53cc\u624b\u62b1\u7740"}),(0,r.jsx)(s.td,{children:"\u663e\u793a\u8868\u60c5\u3001\u72b6\u6001\u680f\u3001\u5bf9\u8bdd\u5b57\u5e55"})]}),(0,r.jsxs)(s.tr,{children:[(0,r.jsx)(s.td,{children:"\u817f\uff08\u5de6\u3001\u53f3\uff09"}),(0,r.jsx)(s.td,{children:"\u8eab\u4f53\u4e0b\u65b9"}),(0,r.jsx)(s.td,{children:"\u7531\u300c\u817f\u8235\u673a\u300d\u5e26\u52a8\uff0c\u5de6\u53f3\u8f6c\u52a8"})]}),(0,r.jsxs)(s.tr,{children:[(0,r.jsx)(s.td,{children:"\u811a\uff08\u5de6\u3001\u53f3\uff09"}),(0,r.jsx)(s.td,{children:"\u817f\u7684\u4e0b\u65b9"}),(0,r.jsx)(s.td,{children:"\u7531\u300c\u811a\u8235\u673a\u300d\u5e26\u52a8\uff0c\u62ac\u8d77\u811a\u638c\u5185\u5916\u4fa7"})]}),(0,r.jsxs)(s.tr,{children:[(0,r.jsx)(s.td,{children:"\u7535\u6e90\u5f00\u5173"}),(0,r.jsxs)(s.td,{children:["\u8eab\u4f53\u4e0b\u65b9",(0,r.jsx)(s.strong,{children:"\u5de6\u4fa7"})]}),(0,r.jsx)(s.td,{children:"\u62e8\u52a8\u5f00\u5173"})]}),(0,r.jsxs)(s.tr,{children:[(0,r.jsx)(s.td,{children:"\u529f\u80fd\u952e\uff08BOOT\uff09"}),(0,r.jsxs)(s.td,{children:["\u8eab\u4f53\u4e0b\u65b9",(0,r.jsx)(s.strong,{children:"\u53f3\u4fa7"})]}),(0,r.jsx)(s.td,{children:"\u5f00\u673a\u540e\u6309\u4e00\u4e0b\uff1a\u8fdb\u5165 / \u9000\u51fa\u5bf9\u8bdd\uff08\u6253\u65ad\uff09\uff1b\u5f00\u673a\u65f6\u6309\u4f4f\uff1a\u8fdb\u5165\u4e0b\u8f7d\u6a21\u5f0f"})]}),(0,r.jsxs)(s.tr,{children:[(0,r.jsx)(s.td,{children:"Type-C \u53e3"}),(0,r.jsx)(s.td,{children:"\u8eab\u4f53\u4e0b\u65b9"}),(0,r.jsx)(s.td,{children:"\u5145\u7535\u3001\u70e7\u5f55\u3001\u770b\u65e5\u5fd7"})]}),(0,r.jsxs)(s.tr,{children:[(0,r.jsx)(s.td,{children:"\u5587\u53ed\u3001\u9ea6\u514b\u98ce"}),(0,r.jsx)(s.td,{children:"\u8eab\u4f53\u5185"}),(0,r.jsx)(s.td,{})]})]})]}),"\n",(0,r.jsx)(s.admonition,{title:"\u5f85\u8865\u5145",type:"info",children:(0,r.jsx)(s.p,{children:"\u5976\u9f99\u5916\u58f3\u5e95\u90e8\u5f00\u5173\u3001\u529f\u80fd\u952e\u3001Type-C \u53e3\u7684\u5b9e\u62cd\u7167\u7247\u3002"})}),"\n",(0,r.jsx)(s.h2,{id:"2-\u5f15\u811a\u5206\u914d",children:"2. \u5f15\u811a\u5206\u914d"}),"\n",(0,r.jsxs)(s.p,{children:["\u4e0b\u9762\u7684\u5f15\u811a\u662f\u5976\u9f99\u56fa\u4ef6 ",(0,r.jsx)(s.code,{children:"main/boards/otto-robot/config.h"})," \u91cc\u7684\u5b9a\u4e49\uff0c\u5b98\u65b9 Otto \u56fa\u4ef6\u76f8\u540c\u3002"]}),"\n",(0,r.jsxs)("figure",{children:[(0,r.jsx)("img",{className:"board-svg",src:"/img/intro/pinout.svg",alt:"ESP32-S3 \u5f15\u811a\u5206\u914d\u56fe\uff1a\u5de6\u817f\u8235\u673a GPIO17\u3001\u5de6\u811a\u8235\u673a GPIO18\u3001\u53f3\u817f\u8235\u673a GPIO39\u3001\u53f3\u811a\u8235\u673a GPIO38\u3001BOOT \u952e GPIO0\u3001\u5145\u7535\u68c0\u6d4b GPIO21\u3001\u7535\u6c60\u7535\u538b ADC2 \u901a\u9053 3\uff1b\u9ea6\u514b\u98ce WS SCK DIN \u4e3a GPIO 4 5 6\uff0c\u529f\u653e DOUT BCLK LRCK \u4e3a GPIO 7 15 16\uff0c\u5c4f\u5e55 MOSI CLK \u4e3a 10 9\uff0cDC RST CS \u4e3a 46 11 12\uff0c\u80cc\u5149\u4e3a 3"}),(0,r.jsx)("figcaption",{children:"ESP32-S3 \u5f15\u811a\u5206\u914d"})]}),"\n",(0,r.jsx)(s.h3,{id:"21-\u8235\u673a",children:"2.1 \u8235\u673a"}),"\n",(0,r.jsxs)(s.table,{children:[(0,r.jsx)(s.thead,{children:(0,r.jsxs)(s.tr,{children:[(0,r.jsx)(s.th,{children:"\u8235\u673a"}),(0,r.jsx)(s.th,{children:"GPIO"}),(0,r.jsx)(s.th,{children:"\u4ee3\u7801\u91cc\u7684\u540d\u5b57"})]})}),(0,r.jsxs)(s.tbody,{children:[(0,r.jsxs)(s.tr,{children:[(0,r.jsx)(s.td,{children:"\u5de6\u817f"}),(0,r.jsx)(s.td,{children:"17"}),(0,r.jsx)(s.td,{children:(0,r.jsx)(s.code,{children:"LEFT_LEG_PIN"})})]}),(0,r.jsxs)(s.tr,{children:[(0,r.jsx)(s.td,{children:"\u5de6\u811a"}),(0,r.jsx)(s.td,{children:"18"}),(0,r.jsx)(s.td,{children:(0,r.jsx)(s.code,{children:"LEFT_FOOT_PIN"})})]}),(0,r.jsxs)(s.tr,{children:[(0,r.jsx)(s.td,{children:"\u53f3\u817f"}),(0,r.jsx)(s.td,{children:"39"}),(0,r.jsx)(s.td,{children:(0,r.jsx)(s.code,{children:"RIGHT_LEG_PIN"})})]}),(0,r.jsxs)(s.tr,{children:[(0,r.jsx)(s.td,{children:"\u53f3\u811a"}),(0,r.jsx)(s.td,{children:"38"}),(0,r.jsx)(s.td,{children:(0,r.jsx)(s.code,{children:"RIGHT_FOOT_PIN"})})]}),(0,r.jsxs)(s.tr,{children:[(0,r.jsx)(s.td,{children:"\u5de6\u624b / \u53f3\u624b"}),(0,r.jsx)(s.td,{children:"-1"}),(0,r.jsx)(s.td,{children:"\u4e0d\u4f7f\u7528\uff0c\u56fa\u4ef6\u4e0d\u4f1a\u6ce8\u518c\u624b\u90e8\u52a8\u4f5c"})]})]})]}),"\n",(0,r.jsxs)(s.p,{children:["\u4e3b\u677f\u4e0a\u6709\u4e09\u7ec4 2\xd73 \u8235\u673a\u6392\u9488\uff08HDR1\u3001HDR3\u3001HDR4\uff09\uff0c\u6bcf\u7ec4\u63a5\u4e24\u4e2a\u8235\u673a\u3002\u6bcf\u4e2a\u8235\u673a\u7684\u4e09\u6839\u7ebf\u4ece\u4fe1\u53f7\u5230\u5730\u4f9d\u6b21\u662f ",(0,r.jsx)(s.strong,{children:"\u4fe1\u53f7 / \u7535\u6e90\uff08\u7535\u6c60\u76f4\u4f9b\uff09/ GND"}),"\uff0c\u6240\u4ee5\u63d2\u7684\u65f6\u5019",(0,r.jsx)(s.strong,{children:"\u68d5\u8272\u7ebf\uff08GND\uff09\u671d\u5916"}),"\u3002"]}),"\n",(0,r.jsxs)(s.table,{children:[(0,r.jsx)(s.thead,{children:(0,r.jsxs)(s.tr,{children:[(0,r.jsx)(s.th,{children:"\u6392\u9488"}),(0,r.jsx)(s.th,{children:"\u63a5\u54ea\u4e24\u4e2a\u8235\u673a"})]})}),(0,r.jsxs)(s.tbody,{children:[(0,r.jsxs)(s.tr,{children:[(0,r.jsx)(s.td,{children:"HDR1"}),(0,r.jsx)(s.td,{children:"\u5de6\u817f\uff08GPIO17\uff09\u3001\u5de6\u811a\uff08GPIO18\uff09"})]}),(0,r.jsxs)(s.tr,{children:[(0,r.jsx)(s.td,{children:"HDR3"}),(0,r.jsx)(s.td,{children:"\u53f3\u817f\uff08GPIO39\uff09\u3001\u53f3\u811a\uff08GPIO38\uff09"})]}),(0,r.jsxs)(s.tr,{children:[(0,r.jsx)(s.td,{children:"HDR4"}),(0,r.jsx)(s.td,{children:"\u624b\u81c2\uff08GPIO8\u3001GPIO12\uff09\uff0c\u5976\u9f99\u4e0d\u7528\uff0c\u7a7a\u7740"})]})]})]}),"\n",(0,r.jsx)(s.admonition,{type:"warning",children:(0,r.jsx)(s.p,{children:"\u6392\u9488\u7684\u7ebf\u5e8f\u662f\u4ece\u539f\u7406\u56fe\u56fe\u7247\u4e0a\u8bfb\u51fa\u6765\u7684\uff0c\u548c\u56fa\u4ef6\u5f15\u811a\u5b9a\u4e49\u4e00\u81f4\uff0c\u4f46\u8fd8\u6ca1\u6709\u5bf9\u7740\u5976\u9f99\u4e3b\u677f\u5b9e\u7269\u9010\u4e2a\u6838\u5bf9\u3002\u63d2\u9519\u65b9\u5411\u4e00\u822c\u4e0d\u4f1a\u7acb\u523b\u635f\u574f\uff0c\u4f46\u8235\u673a\u4e0d\u4f1a\u52a8\uff1b\u63d2\u597d\u540e\u5148\u5f00\u673a\u786e\u8ba4\u56db\u4e2a\u8235\u673a\u90fd\u80fd\u5f52\u4e2d\u3002"})}),"\n",(0,r.jsx)(s.h3,{id:"22-\u97f3\u9891",children:"2.2 \u97f3\u9891"}),"\n",(0,r.jsxs)(s.table,{children:[(0,r.jsx)(s.thead,{children:(0,r.jsxs)(s.tr,{children:[(0,r.jsx)(s.th,{children:"\u4fe1\u53f7"}),(0,r.jsx)(s.th,{children:"GPIO"})]})}),(0,r.jsxs)(s.tbody,{children:[(0,r.jsxs)(s.tr,{children:[(0,r.jsx)(s.td,{children:"\u9ea6\u514b\u98ce WS / SCK / DIN"}),(0,r.jsx)(s.td,{children:"4 / 5 / 6"})]}),(0,r.jsxs)(s.tr,{children:[(0,r.jsx)(s.td,{children:"\u529f\u653e DOUT / BCLK / LRCK"}),(0,r.jsx)(s.td,{children:"7 / 15 / 16"})]})]})]}),"\n",(0,r.jsx)(s.p,{children:"\u9ea6\u514b\u98ce\u91c7\u6837\u7387 16 kHz\uff0c\u64ad\u653e\u91c7\u6837\u7387 24 kHz\uff0c\u4e24\u8def I2S \u5206\u5f00\uff08simplex\uff09\u3002"}),"\n",(0,r.jsx)(s.h3,{id:"23-\u5c4f\u5e55",children:"2.3 \u5c4f\u5e55"}),"\n",(0,r.jsxs)(s.table,{children:[(0,r.jsx)(s.thead,{children:(0,r.jsxs)(s.tr,{children:[(0,r.jsx)(s.th,{children:"\u4fe1\u53f7"}),(0,r.jsx)(s.th,{children:"GPIO"})]})}),(0,r.jsxs)(s.tbody,{children:[(0,r.jsxs)(s.tr,{children:[(0,r.jsx)(s.td,{children:"MOSI / CLK"}),(0,r.jsx)(s.td,{children:"10 / 9"})]}),(0,r.jsxs)(s.tr,{children:[(0,r.jsx)(s.td,{children:"DC / RST / CS"}),(0,r.jsx)(s.td,{children:"46 / 11 / 12"})]}),(0,r.jsxs)(s.tr,{children:[(0,r.jsx)(s.td,{children:"\u80cc\u5149"}),(0,r.jsx)(s.td,{children:"3"})]})]})]}),"\n",(0,r.jsxs)(s.p,{children:["ST7789\uff0c240\xd7240\uff0cSPI mode 3\uff0c\u9700\u8981\u989c\u8272\u53cd\u8f6c\uff08",(0,r.jsx)(s.code,{children:"DISPLAY_INVERT_COLOR true"}),"\uff09\u3002"]}),"\n",(0,r.jsx)(s.h3,{id:"24-\u7535\u6e90\u548c\u6309\u952e",children:"2.4 \u7535\u6e90\u548c\u6309\u952e"}),"\n",(0,r.jsxs)(s.table,{children:[(0,r.jsx)(s.thead,{children:(0,r.jsxs)(s.tr,{children:[(0,r.jsx)(s.th,{children:"\u4fe1\u53f7"}),(0,r.jsx)(s.th,{children:"GPIO"})]})}),(0,r.jsxs)(s.tbody,{children:[(0,r.jsxs)(s.tr,{children:[(0,r.jsx)(s.td,{children:"BOOT \u952e"}),(0,r.jsx)(s.td,{children:"0"})]}),(0,r.jsxs)(s.tr,{children:[(0,r.jsx)(s.td,{children:"\u5145\u7535\u68c0\u6d4b"}),(0,r.jsx)(s.td,{children:"21"})]}),(0,r.jsxs)(s.tr,{children:[(0,r.jsx)(s.td,{children:"\u7535\u6c60\u7535\u538b"}),(0,r.jsx)(s.td,{children:"ADC2 \u901a\u9053 3"})]})]})]}),"\n",(0,r.jsx)(s.admonition,{title:"\u5f85\u8865\u5145",type:"info",children:(0,r.jsxs)(s.p,{children:["\u7acb\u521b\u539f\u7406\u56fe\u4e0a\u6807\u7684\u662f CHG_DET = IO47\u3001BAT_DET = IO21\uff0c\u548c\u56fa\u4ef6 ",(0,r.jsx)(s.code,{children:"config.h"})," \u4e0d\u4e00\u81f4\u3002\u672c\u9875\u4ee5\u5b9e\u9645\u5728\u8dd1\u7684\u56fa\u4ef6\u4e3a\u51c6\uff0c\u539f\u7406\u56fe\u7248\u672c\u5dee\u5f02\u5f85\u786e\u8ba4\u3002"]})}),"\n",(0,r.jsx)(s.h2,{id:"3-\u4e3b\u677f",children:"3. \u4e3b\u677f"}),"\n",(0,r.jsx)(s.p,{children:"\u4e3b\u8981\u82af\u7247\uff08\u7acb\u521b BOM\uff0cottoRobotV1.1\uff09\uff1a"}),"\n",(0,r.jsxs)(s.table,{children:[(0,r.jsx)(s.thead,{children:(0,r.jsxs)(s.tr,{children:[(0,r.jsx)(s.th,{children:"\u4f4d\u53f7"}),(0,r.jsx)(s.th,{children:"\u5668\u4ef6"}),(0,r.jsx)(s.th,{children:"\u4f5c\u7528"})]})}),(0,r.jsxs)(s.tbody,{children:[(0,r.jsxs)(s.tr,{children:[(0,r.jsx)(s.td,{children:"U2"}),(0,r.jsx)(s.td,{children:"ESP32-S3-WROOM-1U-N16R8"}),(0,r.jsx)(s.td,{children:"\u4e3b\u63a7"})]}),(0,r.jsxs)(s.tr,{children:[(0,r.jsx)(s.td,{children:"U5"}),(0,r.jsx)(s.td,{children:"MAX98357AETE+T"}),(0,r.jsx)(s.td,{children:"I2S \u529f\u653e"})]}),(0,r.jsxs)(s.tr,{children:[(0,r.jsx)(s.td,{children:"U7"}),(0,r.jsx)(s.td,{children:"ICS-43434"}),(0,r.jsx)(s.td,{children:"I2S \u9ea6\u514b\u98ce"})]}),(0,r.jsxs)(s.tr,{children:[(0,r.jsx)(s.td,{children:"U8"}),(0,r.jsx)(s.td,{children:"TP4054"}),(0,r.jsx)(s.td,{children:"\u9502\u7535\u5145\u7535"})]}),(0,r.jsxs)(s.tr,{children:[(0,r.jsx)(s.td,{children:"U3"}),(0,r.jsx)(s.td,{children:"HE9073A33M5R"}),(0,r.jsx)(s.td,{children:"3.3 V \u7a33\u538b"})]}),(0,r.jsxs)(s.tr,{children:[(0,r.jsx)(s.td,{children:"U6"}),(0,r.jsx)(s.td,{children:"AO3400A"}),(0,r.jsx)(s.td,{children:"\u5c4f\u5e55\u80cc\u5149\u5f00\u5173"})]}),(0,r.jsxs)(s.tr,{children:[(0,r.jsx)(s.td,{children:"SW1 / SW2"}),(0,r.jsx)(s.td,{children:"XKB5858 \u62e8\u52a8\u5f00\u5173 / TS35CA \u6309\u952e"}),(0,r.jsx)(s.td,{children:"\u7535\u6e90 / \u529f\u80fd\u952e"})]}),(0,r.jsxs)(s.tr,{children:[(0,r.jsx)(s.td,{children:"CN2 / U9"}),(0,r.jsx)(s.td,{children:"1.25 mm 2P / PH2.0 2P"}),(0,r.jsx)(s.td,{children:"\u5587\u53ed / \u7535\u6c60"})]}),(0,r.jsxs)(s.tr,{children:[(0,r.jsx)(s.td,{children:"HDR1 / HDR3 / HDR4"}),(0,r.jsx)(s.td,{children:"2.54 mm 2\xd73 \u6392\u9488"}),(0,r.jsx)(s.td,{children:"\u8235\u673a"})]})]})]}),"\n",(0,r.jsx)(s.admonition,{title:"\u5f85\u8865\u5145",type:"info",children:(0,r.jsx)(s.p,{children:"\u4e3b\u677f\u6b63\u53cd\u9762\u5b9e\u62cd\u548c\u63a5\u53e3\u6807\u6ce8\u56fe\u3002\u7acb\u521b\u9875\u9762\u4e0a\u53ea\u6709\u6574\u673a\u6e32\u67d3\u548c\u6210\u54c1\u7167\u7247\uff0c\u6ca1\u6709\u4e3b\u677f\u7279\u5199\u3002"})})]})}function j(d={}){const{wrapper:s}={...(0,t.R)(),...d.components};return s?(0,r.jsx)(s,{...d,children:(0,r.jsx)(x,{...d})}):x(d)}},107(d,s,e){e.d(s,{R:()=>i,x:()=>l});var n=e(8100);const r={},t=n.createContext(r);function i(d){const s=n.useContext(t);return n.useMemo(function(){return"function"==typeof d?d(s):{...s,...d}},[s,d])}function l(d){let s;return s=d.disableParentContext?"function"==typeof d.components?d.components(r):d.components||r:i(d.components),n.createElement(t.Provider,{value:s},d.children)}}}]);
