lucklyduck/nailongBotWiki/site/assets/js/4f8da41f.e6493635.js

"use strict";(globalThis.webpackChunkwiki_site||=[]).push([[1515],{2243(e,i,n){n.r(i),n.d(i,{assets:()=>o,contentTitle:()=>d,default:()=>a,frontMatter:()=>l,metadata:()=>s,toc:()=>c});const s=JSON.parse('{"id":"intro/index","title":"\u4ea7\u54c1\u4ecb\u7ecd","description":"1. \u7b80\u4ecb","source":"@site/docs/01-intro/index.md","sourceDirName":"01-intro","slug":"/intro","permalink":"/docs/intro","draft":false,"unlisted":false,"tags":[],"version":"current","frontMatter":{"slug":"/intro","title":"\u4ea7\u54c1\u4ecb\u7ecd","sidebar_label":"\u4ea7\u54c1\u4ecb\u7ecd"},"sidebar":"docs","next":{"title":"\u89c4\u683c\u53c2\u6570","permalink":"/docs/intro/specs"}}');var r=n(5272),t=n(107);const l={slug:"/intro",title:"\u4ea7\u54c1\u4ecb\u7ecd",sidebar_label:"\u4ea7\u54c1\u4ecb\u7ecd"},d=void 0,o={},c=[{value:"1. \u7b80\u4ecb",id:"1-\u7b80\u4ecb",level:2},{value:"2. \u5b83\u80fd\u505a\u4ec0\u4e48",id:"2-\u5b83\u80fd\u505a\u4ec0\u4e48",level:2},{value:"3. \u7cfb\u7edf\u6846\u56fe",id:"3-\u7cfb\u7edf\u6846\u56fe",level:2},{value:"4. \u672c\u7ae0\u5185\u5bb9",id:"4-\u672c\u7ae0\u5185\u5bb9",level:2},{value:"5. \u81f4\u8c22",id:"5-\u81f4\u8c22",level:2}];function h(e){const i={a:"a",admonition:"admonition",h2:"h2",li:"li",ol:"ol",p:"p",strong:"strong",table:"table",tbody:"tbody",td:"td",th:"th",thead:"thead",tr:"tr",ul:"ul",...(0,t.R)(),...e.components};return(0,r.jsxs)(r.Fragment,{children:[(0,r.jsx)(i.h2,{id:"1-\u7b80\u4ecb",children:"1. \u7b80\u4ecb"}),"\n",(0,r.jsxs)(i.p,{children:["\u5976\u9f99\u673a\u5668\u4eba\u662f\u4e00\u4e2a\u4f1a\u8bf4\u8bdd\u3001\u4f1a\u8d70\u8def\u3001\u4f1a\u5927\u7b11\u7684\u684c\u9762 AI \u4f19\u4f34\u3002\u5b83\u662f ",(0,r.jsx)(i.strong,{children:"\u77e5\u9020 ZhiForge"})," \u56e2\u961f\uff08catnipent\uff09\u5728 2026 \u77e5\u4e4e\u9ed1\u5ba2\u677e \xb7 \u6821\u56ed\u65b0\u9510\u5b63\u300c\u793e\u4ea4\u7075\u9b42\u5c40\u300d\u8d5b\u9053\u4e0a\u505a\u7684\u5b9e\u7269\u4f5c\u54c1\u3002"]}),"\n",(0,r.jsx)(i.p,{children:"\u5b83\u7531\u4e09\u90e8\u5206\u7ec4\u6210\uff1a"}),"\n",(0,r.jsxs)(i.ul,{children:["\n",(0,r.jsxs)(i.li,{children:[(0,r.jsx)(i.strong,{children:"\u673a\u5668\u4eba\u672c\u4f53"}),"\uff1a\u5f00\u6e90\u7684 ",(0,r.jsx)(i.a,{href:"https://ottodiy.tech/docs/downloads/",children:"\u5c0f\u667a AI Otto \u53cc\u8db3\u673a\u5668\u4eba"}),"\u3002\u4e3b\u63a7\u662f ESP32-S3\uff0c\u914d 4 \u4e2a\u8235\u673a\uff08\u4e24\u6761\u817f\u3001\u4e24\u53ea\u811a\uff09\u548c\u4e00\u5757 1.54 \u5bf8\u5706\u5c4f\u3002"]}),"\n",(0,r.jsxs)(i.li,{children:[(0,r.jsx)(i.strong,{children:"\u5916\u58f3"}),"\uff1a\u5386\u53f2\u6837\u673a\u6709\u5976\u9f99 / \u770b\u5c71\u4e24\u79cd\u9020\u578b\uff0c\u7528\u53cc\u624b\u628a\u5c4f\u5e55\u62b1\u5728\u80f8\u524d\u3002\u5f53\u524d\u8bfe\u7a0b\u6253\u5370\u7edf\u4e00\u4f7f\u7528 ",(0,r.jsx)(i.a,{href:"/docs/assembly/print",children:"\u8fd9\u5957\u6a21\u578b"}),"\uff0c\u542b\u4e00\u79cd\u8eab\u4f53\u5916\u58f3\u3001\u5e95\u5ea7\u3001\u5de6\u53f3\u5361\u9500\u3001\u817f\u548c\u811a\uff0c\u4e0d\u542b\u989d\u5916\u770b\u5c71\u5916\u58f3\u3002"]}),"\n",(0,r.jsxs)(i.li,{children:[(0,r.jsx)(i.strong,{children:"\u5bf9\u8bdd\u540e\u53f0"}),"\uff1a",(0,r.jsx)(i.a,{href:"https://xiaozhi.me/",children:"xiaozhi.me"}),"\uff0c\u8d1f\u8d23\u542c\u61c2\u4f60\u8bf4\u7684\u8bdd\u3001\u6309\u4eba\u8bbe\u60f3\u597d\u600e\u4e48\u56de\u7b54\u3001\u518d\u628a\u8bed\u97f3\u548c\u52a8\u4f5c\u6307\u4ee4\u53d1\u56de\u673a\u5668\u4eba\u3002"]}),"\n"]}),"\n",(0,r.jsxs)("figure",{children:[(0,r.jsx)("img",{src:"/img/photos/hero-three-robots.jpg",alt:"\u4e09\u53ea\u5976\u9f99\u673a\u5668\u4eba\u7ad9\u5728\u6728\u5730\u677f\u4e0a\uff1a\u5de6\u8fb9\u4e00\u53ea\u9ec4\u8272\u5976\u9f99\uff0c\u53f3\u8fb9\u4e24\u53ea\u7070\u767d\u8272\u770b\u5c71\uff0c\u90fd\u662f\u767d\u8272\u817f\u3001\u84dd\u8272\u811a\uff0c\u80f8\u53e3\u62b1\u7740\u4e00\u5757\u5c0f\u5c4f\u5e55"}),(0,r.jsx)("figcaption",{children:"\u9ed1\u5ba2\u677e\u73b0\u573a\u7684\u4e09\u53ea\u6837\u673a\uff1a\u9ec4\u8272\u662f\u5976\u9f99\uff0c\u7070\u767d\u8272\u662f\u770b\u5c71"})]}),"\n",(0,r.jsxs)("figure",{children:[(0,r.jsx)("img",{src:"/img/photos/desk-kanshan.jpg",alt:"\u5de5\u4f4d\u684c\u9762\u4e0a\uff0c\u4e00\u53ea\u767d\u8272\u770b\u5c71\u673a\u5668\u4eba\u548c\u51e0\u4e2a\u52a8\u6f2b\u624b\u529e\u3001\u4e00\u7f50\u53ef\u4e50\u6446\u5728\u4e00\u8d77"}),(0,r.jsx)("figcaption",{children:"\u9ed1\u5ba2\u677e\u5de5\u4f4d\u4e0a\u7684\u770b\u5c71\uff0c\u548c\u5b83\u7684\u670b\u53cb\u4eec"})]}),"\n",(0,r.jsxs)("figure",{children:[(0,r.jsx)("img",{src:"/img/community/makerworld-01.jpg",alt:"\u6e32\u67d3\u56fe\uff1a\u767d\u84dd\u914d\u8272\u7684 Otto \u539f\u7248\uff0c\u65b9\u8111\u888b\u4e0a\u7684\u9ed1\u8272\u5c4f\u5e55\u663e\u793a\u8868\u60c5\uff0c\u5e26\u624b\u81c2\u548c\u84dd\u8272\u5939\u722a"}),(0,r.jsx)("figcaption",{children:"\u5976\u9f99\u7684\u300c\u539f\u578b\u300d\uff1aOtto \u539f\u7248\u5c0f\u667a AI \u673a\u5668\u4eba\uff0c\u65b9\u8111\u888b\u3001\u5e26\u624b\u81c2\uff08\u6765\u6e90\uff1aMakerWorld ottoRobot \u5c0f\u667a AI\uff09"})]}),"\n",(0,r.jsx)(i.h2,{id:"2-\u5b83\u80fd\u505a\u4ec0\u4e48",children:"2. \u5b83\u80fd\u505a\u4ec0\u4e48"}),"\n",(0,r.jsxs)(i.ul,{children:["\n",(0,r.jsxs)(i.li,{children:["\u8bf4\u300c",(0,r.jsx)(i.strong,{children:"\u4f60\u597d\u5976\u9f99"}),"\u300d\u5524\u9192\uff0c\u6216\u8005\u6309\u4e00\u4e0b\u673a\u8eab\u6309\u952e\uff0c\u7136\u540e\u76f4\u63a5\u7528\u4e2d\u6587\u804a\u5929\u3002"]}),"\n",(0,r.jsx)(i.li,{children:"\u5c4f\u5e55\u663e\u793a\u8868\u60c5\u548c\u5bf9\u8bdd\u5b57\u5e55\u3002"}),"\n",(0,r.jsx)(i.li,{children:"\u7528\u8bed\u97f3\u8ba9\u5b83\u8d70\u8def\u3001\u8f6c\u8eab\u3001\u8df3\u3001\u6447\u6446\u3001\u592a\u7a7a\u6b65\u3001\u5927\u7b11\u3002"}),"\n",(0,r.jsx)(i.li,{children:"\u5927\u6a21\u578b\u4f1a\u6309\u4eba\u8bbe\u81ea\u5df1\u51b3\u5b9a\u4ec0\u4e48\u65f6\u5019\u505a\u52a8\u4f5c\uff0c\u6bd4\u5982\u542c\u4e0d\u61c2\u65f6\u5927\u7b11\u4e00\u58f0\u3002"}),"\n",(0,r.jsx)(i.li,{children:"\u5728 xiaozhi.me \u4e0a\u968f\u65f6\u6362\u4eba\u8bbe\u3001\u6362\u58f0\u97f3\u3001\u6362\u5927\u6a21\u578b\uff0c\u4e0d\u7528\u91cd\u65b0\u70e7\u5f55\u3002"}),"\n"]}),"\n",(0,r.jsxs)("figure",{children:[(0,r.jsx)("video",{controls:!0,playsInline:!0,preload:"none",poster:"/video/three-lit.jpg",style:{width:"100%",borderRadius:8},"aria-label":"\u4e09\u53ea\u4eae\u7740\u5c4f\u5e55\u7684\u5976\u9f99\u548c\u770b\u5c71\u673a\u5668\u4eba\u7ad9\u5728\u4e00\u8d77\uff0c\u5c4f\u5e55\u4e0a\u662f\u8868\u60c5",children:(0,r.jsx)("source",{src:"/video/three-lit.mp4",type:"video/mp4"})}),(0,r.jsx)("figcaption",{children:"\u4e09\u53ea\u6837\u673a\u4eae\u5c4f\u7ad9\u5728\u4e00\u8d77\uff08\u6f14\u793a\u89c6\u9891\uff09"})]}),"\n",(0,r.jsxs)("figure",{children:[(0,r.jsx)("video",{controls:!0,playsInline:!0,preload:"none",poster:"/video/walk-three-back.jpg",style:{width:"100%",borderRadius:8},"aria-label":"\u4ece\u80cc\u540e\u62cd\u4e09\u53ea\u673a\u5668\u4eba\u5728\u6728\u5730\u677f\u4e0a\u4e00\u8d77\u5411\u524d\u8d70",children:(0,r.jsx)("source",{src:"/video/walk-three-back.mp4",type:"video/mp4"})}),(0,r.jsx)("figcaption",{children:"\u4ece\u80cc\u540e\u770b\u4e09\u53ea\u4e00\u8d77\u8d70\uff08\u6f14\u793a\u89c6\u9891\uff09"})]}),"\n",(0,r.jsx)(i.h2,{id:"3-\u7cfb\u7edf\u6846\u56fe",children:"3. \u7cfb\u7edf\u6846\u56fe"}),"\n",(0,r.jsxs)("figure",{children:[(0,r.jsx)("img",{className:"board-svg",src:"/img/intro/system.svg",alt:"\u7cfb\u7edf\u6846\u56fe\uff1a\u673a\u5668\u4eba\u5185\u7684\u5c0f\u667a\u56fa\u4ef6\u8fde\u63a5\u9ea6\u514b\u98ce\u3001\u5587\u53ed\u3001BOOT \u952e\u3001\u5706\u5c4f\u30014 \u4e2a\u8235\u673a\u548c\u7535\u6c60\uff1b\u673a\u5668\u4eba\u901a\u8fc7 Wi-Fi \u628a\u8bed\u97f3\u53d1\u5230 xiaozhi.me \u4e91\u7aef\uff0c\u4e91\u7aef\u7ecf\u8fc7\u8bed\u97f3\u8bc6\u522b\u3001\u5927\u6a21\u578b\u52a0\u89d2\u8272\u4eba\u8bbe\u3001\u8bed\u97f3\u5408\u6210\u540e\uff0c\u628a\u56de\u590d\u8bed\u97f3\u3001\u8868\u60c5\u548c\u52a8\u4f5c\u6307\u4ee4\u53d1\u56de\u673a\u5668\u4eba"}),(0,r.jsx)("figcaption",{children:"\u673a\u5668\u4eba\u8d1f\u8d23\u300c\u542c\u3001\u8bf4\u3001\u52a8\u3001\u663e\u793a\u300d\uff0cxiaozhi.me \u8d1f\u8d23\u300c\u542c\u61c2\u3001\u601d\u8003\u3001\u8bf4\u51fa\u6765\u300d"})]}),"\n",(0,r.jsxs)(i.ol,{children:["\n",(0,r.jsx)(i.li,{children:"\u9ea6\u514b\u98ce\u6536\u5230\u5524\u9192\u8bcd\u540e\uff0c\u56fa\u4ef6\u5f00\u59cb\u628a\u4f60\u7684\u58f0\u97f3\u901a\u8fc7 Wi-Fi \u53d1\u7ed9 xiaozhi.me\u3002"}),"\n",(0,r.jsx)(i.li,{children:"xiaozhi.me \u505a\u8bed\u97f3\u8bc6\u522b\uff0c\u628a\u6587\u5b57\u548c\u89d2\u8272\u4eba\u8bbe\u4e00\u8d77\u4ea4\u7ed9\u5927\u6a21\u578b\u3002"}),"\n",(0,r.jsxs)(i.li,{children:["\u5927\u6a21\u578b\u751f\u6210\u56de\u7b54\uff0c\u9700\u8981\u52a8\u4f5c\u65f6\u8c03\u7528\u673a\u5668\u4eba\u4e0a\u7684 ",(0,r.jsx)(i.strong,{children:"MCP \u5de5\u5177"}),"\uff08MCP\uff1a\u4e00\u79cd\u8ba9\u5927\u6a21\u578b\u8c03\u7528\u5916\u90e8\u529f\u80fd\u7684\u534f\u8bae\uff0c\u8fd9\u91cc\u7684\u300c\u5916\u90e8\u529f\u80fd\u300d\u5c31\u662f\u673a\u5668\u4eba\u7684\u52a8\u4f5c\uff09\u3002"]}),"\n",(0,r.jsx)(i.li,{children:"\u56de\u7b54\u88ab\u5408\u6210\u6210\u8bed\u97f3\u53d1\u56de\u673a\u5668\u4eba\u64ad\u653e\uff0c\u540c\u65f6\u5c4f\u5e55\u5207\u6362\u8868\u60c5\u3001\u8235\u673a\u6267\u884c\u52a8\u4f5c\u3002"}),"\n"]}),"\n",(0,r.jsx)(i.h2,{id:"4-\u672c\u7ae0\u5185\u5bb9",children:"4. \u672c\u7ae0\u5185\u5bb9"}),"\n",(0,r.jsxs)(i.table,{children:[(0,r.jsx)(i.thead,{children:(0,r.jsxs)(i.tr,{children:[(0,r.jsx)(i.th,{children:"\u9875\u9762"}),(0,r.jsx)(i.th,{children:"\u5185\u5bb9"})]})}),(0,r.jsxs)(i.tbody,{children:[(0,r.jsxs)(i.tr,{children:[(0,r.jsx)(i.td,{children:(0,r.jsx)(i.a,{href:"/docs/intro/specs",children:"\u89c4\u683c\u53c2\u6570"})}),(0,r.jsx)(i.td,{children:"\u4e3b\u63a7\u3001\u8235\u673a\u3001\u5c4f\u5e55\u3001\u97f3\u9891\u3001\u7535\u6c60\u3001\u5c3a\u5bf8"})]}),(0,r.jsxs)(i.tr,{children:[(0,r.jsx)(i.td,{children:(0,r.jsx)(i.a,{href:"/docs/intro/parts",children:"\u90e8\u4ef6\u4e0e\u5f15\u811a"})}),(0,r.jsx)(i.td,{children:"\u6bcf\u4e2a\u90e8\u4ef6\u63a5\u5728\u54ea\u4e2a GPIO \u4e0a"})]}),(0,r.jsxs)(i.tr,{children:[(0,r.jsx)(i.td,{children:(0,r.jsx)(i.a,{href:"/docs/intro/status",children:"\u529f\u80fd\u72b6\u6001"})}),(0,r.jsx)(i.td,{children:"\u5b98\u65b9\u56fa\u4ef6\u548c\u5976\u9f99\u56fa\u4ef6\u5404\u652f\u6301\u54ea\u4e9b\u529f\u80fd"})]}),(0,r.jsxs)(i.tr,{children:[(0,r.jsx)(i.td,{children:(0,r.jsx)(i.a,{href:"/docs/intro/path",children:"\u5b66\u4e60\u8def\u7ebf"})}),(0,r.jsx)(i.td,{children:"\u7b2c\u4e00\u6b21\u505a\uff1f\u6309 Task 0\uff5e5 \u4e00\u6b65\u6b65\u6765"})]})]})]}),"\n",(0,r.jsx)(i.admonition,{type:"nailong",children:(0,r.jsx)(i.p,{children:"\u6211\u662f\u5976\u9f99\uff0c\u5927\u5bb6\u597d\uff01\u6211\u80fd\u542c\u3001\u80fd\u8bf4\u3001\u80fd\u8d70\u4e24\u6b65\uff0c\u8fd8\u4f1a\u54c8\u54c8\u5927\u7b11\u3002\u542c\u4e0d\u61c2\u4f60\u8bf4\u5565\u7684\u65f6\u5019\uff0c\u6211\u5c31\u7b11\u7ed9\u4f60\u770b\u3002"})}),"\n",(0,r.jsx)(i.admonition,{type:"tip",children:(0,r.jsxs)(i.p,{children:["\u7b2c\u4e00\u6b21\u505a\u7684\u8bdd\uff0c\u5148\u770b ",(0,r.jsx)(i.a,{href:"/docs/intro/path",children:"\u5b66\u4e60\u8def\u7ebf"}),"\uff1a6 \u4e2a\u4efb\u52a1\uff0c\u4e00\u4e2a\u5468\u672b\u4ece\u96f6\u4ef6\u8d70\u5230\u4f1a\u8bf4\u8bdd\u7684\u5976\u9f99\u3002"]})}),"\n",(0,r.jsx)(i.h2,{id:"5-\u81f4\u8c22",children:"5. \u81f4\u8c22"}),"\n",(0,r.jsxs)(i.ul,{children:["\n",(0,r.jsxs)(i.li,{children:[(0,r.jsx)(i.a,{href:"https://github.com/78/xiaozhi-esp32",children:"\u5c0f\u667a AI\uff0878/xiaozhi-esp32\uff09"}),"\uff1a\u786c\u4ef6\u7aef\u5bf9\u8bdd\u529f\u80fd\u4e0e\u6e90\u7801\u53c2\u8003"]}),"\n",(0,r.jsxs)(i.li,{children:[(0,r.jsx)(i.a,{href:"https://github.com/espressif/esp-idf",children:"ESP-IDF"}),"\uff1a\u5d4c\u5165\u5f0f\u5f00\u53d1\u3001\u7f16\u8bd1\u4e0e\u70e7\u5f55\u6846\u67b6"]}),"\n",(0,r.jsxs)(i.li,{children:[(0,r.jsx)(i.a,{href:"https://github.com/txp666/ottodiy-docs",children:"\u5c0f\u9e4f ottoRobot"}),"\uff1a\u673a\u5668\u4eba\u7ed3\u6784\u4e0e PCB \u5f00\u6e90\u53c2\u8003"]}),"\n"]})]})}function a(e={}){const{wrapper:i}={...(0,t.R)(),...e.components};return i?(0,r.jsx)(i,{...e,children:(0,r.jsx)(h,{...e})}):h(e)}},107(e,i,n){n.d(i,{R:()=>l,x:()=>d});var s=n(8100);const r={},t=s.createContext(r);function l(e){const i=s.useContext(t);return s.useMemo(function(){return"function"==typeof e?e(i):{...i,...e}},[i,e])}function d(e){let i;return i=e.disableParentContext?"function"==typeof e.components?e.components(r):e.components||r:l(e.components),s.createElement(t.Provider,{value:i},e.children)}}}]);
