lucklyduck/nailongBotWiki/site/assets/js/00312378.66623b8f.js

"use strict";(globalThis.webpackChunkwiki_site||=[]).push([[4859],{4952(e,n,s){s.r(n),s.d(n,{assets:()=>o,contentTitle:()=>c,default:()=>h,frontMatter:()=>r,metadata:()=>i,toc:()=>d});const i=JSON.parse('{"id":"assembly/center","title":"\u8235\u673a\u5f52\u4e2d","description":"1. \u7b80\u4ecb","source":"@site/docs/02-assembly/04-center.md","sourceDirName":"02-assembly","slug":"/assembly/center","permalink":"/docs/assembly/center","draft":false,"unlisted":false,"tags":[],"version":"current","sidebarPosition":4,"frontMatter":{"slug":"/assembly/center","title":"\u8235\u673a\u5f52\u4e2d","sidebar_label":"\u8235\u673a\u5f52\u4e2d"},"sidebar":"docs","previous":{"title":"\u710a\u63a5\u4e3b\u677f","permalink":"/docs/assembly/solder"},"next":{"title":"\u88c5\u817f\u548c\u811a","permalink":"/docs/assembly/legs"}}');var l=s(5272),t=s(107);const r={slug:"/assembly/center",title:"\u8235\u673a\u5f52\u4e2d",sidebar_label:"\u8235\u673a\u5f52\u4e2d"},c=void 0,o={},d=[{value:"1. \u7b80\u4ecb",id:"1-\u7b80\u4ecb",level:2},{value:"2. \u63a5\u7ebf",id:"2-\u63a5\u7ebf",level:2},{value:"3. \u70e7\u5f55\u5e76\u5f52\u4e2d",id:"3-\u70e7\u5f55\u5e76\u5f52\u4e2d",level:2}];function a(e){const n={a:"a",admonition:"admonition",h2:"h2",li:"li",ol:"ol",p:"p",strong:"strong",ul:"ul",...(0,t.R)(),...e.components};return(0,l.jsxs)(l.Fragment,{children:[(0,l.jsx)(n.h2,{id:"1-\u7b80\u4ecb",children:"1. \u7b80\u4ecb"}),"\n",(0,l.jsxs)(n.p,{children:["SG90 \u8235\u673a\u80fd\u5728 0\xb0\uff5e180\xb0 \u4e4b\u95f4\u8f6c\u3002\u56fa\u4ef6\u542f\u52a8\u65f6\u4f1a\u628a\u6bcf\u4e2a\u8235\u673a\u8f6c\u5230 ",(0,l.jsx)(n.strong,{children:"90\xb0"}),"\uff08\u4e2d\u95f4\u4f4d\u7f6e\uff09\uff0c\u8fd9\u5c31\u662f\u673a\u5668\u4eba\u7684\u300c\u7ad9\u7acb\u96f6\u4f4d\u300d\u3002",(0,l.jsx)(n.strong,{children:"\u88c5\u817f\u4e4b\u524d\u5fc5\u987b\u5148\u8ba9\u8235\u673a\u8f6c\u5230 90\xb0"}),"\uff0c\u518d\u6309\u8fd9\u4e2a\u4f4d\u7f6e\u88c5\u6447\u81c2\uff0c\u8fd9\u6837\u7ad9\u59ff\u624d\u6b63\u3002"]}),"\n",(0,l.jsx)(n.h2,{id:"2-\u63a5\u7ebf",children:"2. \u63a5\u7ebf"}),"\n",(0,l.jsxs)("figure",{children:[(0,l.jsx)("img",{className:"board-svg",src:"/img/assembly/servo-header.svg",alt:"\u8235\u673a\u6392\u9488\u793a\u610f\uff1aHDR1 \u4e0a\u6392\u63a5\u5de6\u817f GPIO17\u3001\u4e0b\u6392\u63a5\u5de6\u811a GPIO18\uff0cHDR3 \u4e0a\u6392\u63a5\u53f3\u817f GPIO39\u3001\u4e0b\u6392\u63a5\u53f3\u811a GPIO38\uff0c\u6bcf\u6392\u4e09\u4e2a\u9488\u4ece\u677f\u5b50\u5916\u4fa7\u5f80\u91cc\u4f9d\u6b21\u662f GND \u68d5\u7ebf\u3001\u7535\u6e90\u7ea2\u7ebf\u3001\u4fe1\u53f7\u6a59\u9ec4\u7ebf\uff1bHDR4 \u63a5\u624b\u81c2\uff0c\u5976\u9f99\u4e0d\u7528"}),(0,l.jsx)("figcaption",{children:"\u8235\u673a\u600e\u4e48\u63d2\uff1a\u4e0a\u817f\u4e0b\u811a\uff0c\u68d5\u7ebf\u671d\u5916"})]}),"\n",(0,l.jsxs)("div",{className:"img-grid",children:[(0,l.jsxs)("figure",{children:[(0,l.jsx)("img",{src:"/img/ottodiy/assembly-02.webp",alt:"\u5b9e\u62cd\uff1a\u4e3b\u677f\u5df2\u7ecf\u63a5\u597d\u9502\u7535\u6c60\u3001\u5587\u53ed\u3001\u9ed1\u8272\u5929\u7ebf\u548c\u591a\u6839\u8235\u673a\u7ebf"}),(0,l.jsx)("figcaption",{children:"\u5b9e\u62cd\uff1a\u4e3b\u677f\u63a5\u597d\u7535\u6c60\u3001\u5587\u53ed\u3001\u5929\u7ebf\u548c\u8235\u673a\u7ebf\uff08\u6765\u6e90\uff1aottodiy.tech \u7ec4\u88c5\u6559\u7a0b \u56fe 2\uff09"})]}),(0,l.jsxs)("figure",{children:[(0,l.jsx)("img",{src:"/img/ottodiy/assembly-14.webp",alt:"\u6e32\u67d3\u56fe\uff1a\u4ece\u4e0a\u5f80\u4e0b\u770b\u673a\u8eab\u5185\u90e8\uff0c\u7ea2\u6846\u6807\u6ce8\u8235\u673a\u68d5\u8272\u7ebf\u5728\u5916\u4fa7\u3001\u4e0a\u817f\u4e0b\u8db3\uff0c\u4ee5\u53ca\u5929\u7ebf\u3001\u5587\u53ed\u548c 4G \u6a21\u5757\u63a5\u53e3\u7684\u4f4d\u7f6e"}),(0,l.jsx)("figcaption",{children:"\u6e32\u67d3\u56fe\uff1a\u7ea2\u6846\u5904\u5199\u7740\u300c\u68d5\u8272\u7ebf\u5728\u5916\u4fa7\uff0c\u4e0a\u817f\u4e0b\u8db3\u300d\uff08\u6765\u6e90\uff1aottodiy.tech \u7ec4\u88c5\u6559\u7a0b \u56fe 14\uff09"})]})]}),"\n",(0,l.jsxs)(n.ol,{children:["\n",(0,l.jsxs)(n.li,{children:["\u628a 4 \u4e2a\u8235\u673a\u63d2\u5230\u4e3b\u677f\u7684\u8235\u673a\u6392\u9488\u4e0a\uff1a","\n",(0,l.jsxs)(n.ul,{children:["\n",(0,l.jsxs)(n.li,{children:[(0,l.jsx)(n.strong,{children:"HDR1"}),"\uff1a\u4e0a\u6392\u5de6\u817f\uff0c\u4e0b\u6392\u5de6\u811a"]}),"\n",(0,l.jsxs)(n.li,{children:[(0,l.jsx)(n.strong,{children:"HDR3"}),"\uff1a\u4e0a\u6392\u53f3\u817f\uff0c\u4e0b\u6392\u53f3\u811a"]}),"\n",(0,l.jsxs)(n.li,{children:["\u6bcf\u4e2a\u63d2\u5934\u7684",(0,l.jsx)(n.strong,{children:"\u68d5\u8272\u7ebf\uff08GND\uff09\u671d\u4e3b\u677f\u5916\u4fa7"})]}),"\n"]}),"\n"]}),"\n",(0,l.jsx)(n.li,{children:"\u63a5\u4e0a\u5587\u53ed\uff081.25 mm 2P \u5ea7\uff09\u548c\u7535\u6c60\uff08PH2.0 \u5ea7\uff09\u3002"}),"\n"]}),"\n",(0,l.jsx)(n.admonition,{type:"warning",children:(0,l.jsx)(n.p,{children:"\u8235\u673a\u7ebf\u5e8f\u6765\u81ea ottodiy \u7ec4\u88c5\u6559\u7a0b\u548c\u539f\u7406\u56fe\u56fe\u7247\uff0c\u8fd8\u6ca1\u6709\u5bf9\u7740\u5976\u9f99\u4e3b\u677f\u9010\u4e2a\u62cd\u7167\u6838\u5bf9\u3002\u4ee5\u4e3b\u677f\u4e1d\u5370\u4e3a\u51c6\uff0c\u63d2\u597d\u540e\u6309\u4e0b\u9762\u7684\u6b65\u9aa4\u786e\u8ba4\u56db\u4e2a\u8235\u673a\u90fd\u4f1a\u8f6c\u3002"})}),"\n",(0,l.jsx)(n.h2,{id:"3-\u70e7\u5f55\u5e76\u5f52\u4e2d",children:"3. \u70e7\u5f55\u5e76\u5f52\u4e2d"}),"\n",(0,l.jsxs)(n.ol,{children:["\n",(0,l.jsxs)(n.li,{children:["\u6309 ",(0,l.jsx)(n.a,{href:"/docs/flash",children:"\u70e7\u5f55"})," \u5199\u5165\u56fa\u4ef6\uff08\u5b98\u65b9\u6216\u5976\u9f99\u56fa\u4ef6\u90fd\u53ef\u4ee5\uff09\u3002\u4e70\u7684\u5957\u4ef6\u56fa\u4ef6\u5df2\u7ecf\u70e7\u597d\uff0c\u8df3\u8fc7\u8fd9\u4e00\u6b65\u3002"]}),"\n",(0,l.jsx)(n.li,{children:"\u6253\u5f00\u7535\u6e90\u5f00\u5173\u3002\u56db\u4e2a\u8235\u673a\u4f1a\u5404\u81ea\u8f6c\u4e00\u4e0b\uff0c\u505c\u5728 90\xb0\u3002"}),"\n",(0,l.jsx)(n.li,{children:"\u5173\u6389\u7535\u6e90\u5f00\u5173\u3002"}),"\n",(0,l.jsxs)(n.li,{children:[(0,l.jsx)(n.strong,{children:"\u62d4\u4e0b\u8235\u673a\u7ebf"}),"\uff08\u8235\u673a\u5148\u522b\u62c6\uff09\uff0c\u7b49\u673a\u8eab\u88c5\u597d\u540e\u518d\u63d2\u56de\u53bb\u3002"]}),"\n"]}),"\n",(0,l.jsx)(n.admonition,{type:"warning",children:(0,l.jsxs)(n.p,{children:["\u4ece\u8fd9\u4e00\u523b\u8d77\uff0c",(0,l.jsx)(n.strong,{children:"\u4e0d\u8981\u7528\u624b\u62e7\u8235\u673a\u7684\u8f93\u51fa\u8f74"}),"\u3002\u62e7\u52a8\u4e86\u5c31\u8981\u91cd\u65b0\u4e0a\u7535\u5f52\u4e2d\u4e00\u6b21\u3002"]})}),"\n",(0,l.jsx)(n.admonition,{type:"nailong",children:(0,l.jsx)(n.p,{children:"\u5982\u679c\u67d0\u4e2a\u8235\u673a\u4e0a\u7535\u540e\u5b8c\u5168\u4e0d\u52a8\uff0c\u5148\u770b\u770b\u63d2\u5934\u662f\u4e0d\u662f\u63d2\u53cd\u4e86\uff08\u68d5\u7ebf\u8981\u671d\u5916\uff09\uff0c\u518d\u770b\u7535\u6c60\u6709\u6ca1\u6709\u7535\u3002"})})]})}function h(e={}){const{wrapper:n}={...(0,t.R)(),...e.components};return n?(0,l.jsx)(n,{...e,children:(0,l.jsx)(a,{...e})}):a(e)}},107(e,n,s){s.d(n,{R:()=>r,x:()=>c});var i=s(8100);const l={},t=i.createContext(l);function r(e){const n=i.useContext(t);return i.useMemo(function(){return"function"==typeof e?e(n):{...n,...e}},[n,e])}function c(e){let n;return n=e.disableParentContext?"function"==typeof e.components?e.components(l):e.components||l:r(e.components),i.createElement(t.Provider,{value:n},e.children)}}}]);
