lucklyduck/nailongBotWiki/site/assets/js/bd87d24d.c62b5fc0.js

"use strict";(globalThis.webpackChunkwiki_site||=[]).push([[4280],{5911(t,e,s){s.r(e),s.d(e,{assets:()=>l,contentTitle:()=>c,default:()=>j,frontMatter:()=>i,metadata:()=>d,toc:()=>h});const d=JSON.parse('{"id":"intro/specs","title":"\u89c4\u683c\u53c2\u6570","description":"1. \u786c\u4ef6\u89c4\u683c","source":"@site/docs/01-intro/01-specs.md","sourceDirName":"01-intro","slug":"/intro/specs","permalink":"/docs/intro/specs","draft":false,"unlisted":false,"tags":[],"version":"current","sidebarPosition":1,"frontMatter":{"slug":"/intro/specs","title":"\u89c4\u683c\u53c2\u6570","sidebar_label":"\u89c4\u683c\u53c2\u6570"},"sidebar":"docs","previous":{"title":"\u4ea7\u54c1\u4ecb\u7ecd","permalink":"/docs/intro"},"next":{"title":"\u90e8\u4ef6\u4e0e\u5f15\u811a","permalink":"/docs/intro/parts"}}');var r=s(4848),n=s(8453);const i={slug:"/intro/specs",title:"\u89c4\u683c\u53c2\u6570",sidebar_label:"\u89c4\u683c\u53c2\u6570"},c=void 0,l={},h=[{value:"1. \u786c\u4ef6\u89c4\u683c",id:"1-\u786c\u4ef6\u89c4\u683c",level:2},{value:"2. \u8f6f\u4ef6\u89c4\u683c",id:"2-\u8f6f\u4ef6\u89c4\u683c",level:2}];function x(t){const e={a:"a",h2:"h2",p:"p",table:"table",tbody:"tbody",td:"td",th:"th",thead:"thead",tr:"tr",...(0,n.R)(),...t.components};return(0,r.jsxs)(r.Fragment,{children:[(0,r.jsx)(e.h2,{id:"1-\u786c\u4ef6\u89c4\u683c",children:"1. \u786c\u4ef6\u89c4\u683c"}),"\n",(0,r.jsxs)(e.table,{children:[(0,r.jsx)(e.thead,{children:(0,r.jsxs)(e.tr,{children:[(0,r.jsx)(e.th,{children:"\u9879\u76ee"}),(0,r.jsx)(e.th,{children:"\u89c4\u683c"})]})}),(0,r.jsxs)(e.tbody,{children:[(0,r.jsxs)(e.tr,{children:[(0,r.jsx)(e.td,{children:"\u4e3b\u63a7"}),(0,r.jsx)(e.td,{children:"ESP32-S3-WROOM-1U-N16R8\uff08\u5916\u63a5\u5929\u7ebf\u7248\uff09\uff0c\u53cc\u6838 Xtensa LX7 240 MHz\uff1b\u677f\u8f7d\u5929\u7ebf\u7248 -1 \u4e5f\u80fd\u7528"})]}),(0,r.jsxs)(e.tr,{children:[(0,r.jsx)(e.td,{children:"\u5b58\u50a8"}),(0,r.jsx)(e.td,{children:"16 MB Flash\uff0c8 MB Octal PSRAM"})]}),(0,r.jsxs)(e.tr,{children:[(0,r.jsx)(e.td,{children:"\u65e0\u7ebf"}),(0,r.jsx)(e.td,{children:"2.4 GHz Wi-Fi\uff0c\u84dd\u7259 5\uff08LE\uff09"})]}),(0,r.jsxs)(e.tr,{children:[(0,r.jsx)(e.td,{children:"\u8235\u673a"}),(0,r.jsx)(e.td,{children:"SG90 9g 180\xb0 \xd7 4\uff1a\u5de6\u817f\u3001\u53f3\u817f\u3001\u5de6\u811a\u3001\u53f3\u811a"})]}),(0,r.jsxs)(e.tr,{children:[(0,r.jsx)(e.td,{children:"\u5c4f\u5e55"}),(0,r.jsx)(e.td,{children:"1.54 \u5bf8 IPS\uff0c240 \xd7 240\uff0cST7789 \u9a71\u52a8\uff0cSPI \u63a5\u53e3"})]}),(0,r.jsxs)(e.tr,{children:[(0,r.jsx)(e.td,{children:"\u9ea6\u514b\u98ce"}),(0,r.jsx)(e.td,{children:"ICS-43434 \u6216 INMP441\uff0cI2S \u6570\u5b57\u9ea6\u514b\u98ce"})]}),(0,r.jsxs)(e.tr,{children:[(0,r.jsx)(e.td,{children:"\u529f\u653e"}),(0,r.jsx)(e.td,{children:"MAX98357A\uff0cI2S \u8f93\u5165\uff0cD \u7c7b"})]}),(0,r.jsxs)(e.tr,{children:[(0,r.jsx)(e.td,{children:"\u5587\u53ed"}),(0,r.jsx)(e.td,{children:"2828 \u8154\u4f53\u5587\u53ed\uff0c4 \u03a9 3 W"})]}),(0,r.jsxs)(e.tr,{children:[(0,r.jsx)(e.td,{children:"\u7535\u6c60"}),(0,r.jsx)(e.td,{children:"103450 \u9502\u7535 2000 mAh\uff0c\u6216\u53cc 18650 \u7535\u6c60\u5305 3.7 V 2200 mAh"})]}),(0,r.jsxs)(e.tr,{children:[(0,r.jsx)(e.td,{children:"\u5145\u7535"}),(0,r.jsx)(e.td,{children:"USB Type-C \u8f93\u5165\uff0cTP4054 \u9502\u7535\u5145\u7535\uff0c\u5e26\u5145\u7535\u6307\u793a\u706f"})]}),(0,r.jsxs)(e.tr,{children:[(0,r.jsx)(e.td,{children:"\u7a33\u538b"}),(0,r.jsx)(e.td,{children:"HE9073A33M5R 3.3 V LDO"})]}),(0,r.jsxs)(e.tr,{children:[(0,r.jsx)(e.td,{children:"\u6309\u952e"}),(0,r.jsx)(e.td,{children:"\u7535\u6e90\u62e8\u52a8\u5f00\u5173\uff08\u8eab\u4f53\u4e0b\u65b9\u5de6\u4fa7\uff09\xd7 1\uff0c\u529f\u80fd\u952e\uff08\u8eab\u4f53\u4e0b\u65b9\u53f3\u4fa7\uff0cGPIO0\uff1a\u6253\u65ad / \u5524\u9192 / \u914d\u7f51\uff0c\u70e7\u5f55\u65f6\u5f53 BOOT \u952e\u7528\uff09\xd7 1"})]}),(0,r.jsxs)(e.tr,{children:[(0,r.jsx)(e.td,{children:"\u4e3b\u677f"}),(0,r.jsx)(e.td,{children:(0,r.jsx)(e.a,{href:"https://pro.lceda.cn/editor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",children:"\u7acb\u521b\u5f00\u6e90 ottoRobot V1.1\uff0c\u4f5c\u8005\u5c0f\u9e4f\uff08txp666\uff09\uff0cCC BY-NC-SA 4.0"})})]}),(0,r.jsxs)(e.tr,{children:[(0,r.jsx)(e.td,{children:"\u6253\u5370\u7ed3\u6784\u4ef6"}),(0,r.jsxs)(e.td,{children:[(0,r.jsx)(e.a,{href:"/docs/assembly/print",children:"\u5f53\u524d\u6a21\u578b\u5305"}),"\uff1a\u8eab\u4f53\u5916\u58f3\u3001\u65e0\u624b\u81c2\u5e95\u5ea7\u3001\u5de6\u53f3\u5361\u9500\u3001\u5de6\u53f3\u817f\u3001\u5de6\u53f3\u811a\uff1b8 \u4e2a STL \u5404 1 \u4ef6\uff0c\u6750\u6599\u4e0e\u53c2\u6570\u6309\u5207\u7247\u53ca\u8bd5\u88c5\u786e\u5b9a"]})]})]})]}),"\n",(0,r.jsx)(e.h2,{id:"2-\u8f6f\u4ef6\u89c4\u683c",children:"2. \u8f6f\u4ef6\u89c4\u683c"}),"\n",(0,r.jsxs)(e.table,{children:[(0,r.jsx)(e.thead,{children:(0,r.jsxs)(e.tr,{children:[(0,r.jsx)(e.th,{children:"\u9879\u76ee"}),(0,r.jsx)(e.th,{children:"\u5b98\u65b9 Otto \u56fa\u4ef6"}),(0,r.jsx)(e.th,{children:"\u5976\u9f99\u5b9a\u5236\u56fa\u4ef6"})]})}),(0,r.jsxs)(e.tbody,{children:[(0,r.jsxs)(e.tr,{children:[(0,r.jsx)(e.td,{children:"\u5f53\u524d\u7248\u672c"}),(0,r.jsx)(e.td,{children:"v2.5.3\uff082026-10-19\uff09"}),(0,r.jsx)(e.td,{children:"2.0.16"})]}),(0,r.jsxs)(e.tr,{children:[(0,r.jsx)(e.td,{children:"\u57fa\u4e8e"}),(0,r.jsx)(e.td,{children:"\u5c0f\u667a 2.5.3"}),(0,r.jsx)(e.td,{children:"\u5c0f\u667a 2.0.x"})]}),(0,r.jsxs)(e.tr,{children:[(0,r.jsx)(e.td,{children:"\u5524\u9192\u8bcd"}),(0,r.jsx)(e.td,{children:"\u4f60\u597d\u5c0f\u667a"}),(0,r.jsx)(e.td,{children:"\u4f60\u597d\u5976\u9f99"})]}),(0,r.jsxs)(e.tr,{children:[(0,r.jsx)(e.td,{children:"\u8868\u60c5"}),(0,r.jsx)(e.td,{children:"21 \u4e2a\u91cd\u7ed8\u8868\u60c5"}),(0,r.jsx)(e.td,{children:"21 \u4e2a\u300c\u770b\u5c71\u300d\u5355\u8272\u8868\u60c5 + \u52a8\u4f5c\u8d34\u56fe"})]}),(0,r.jsxs)(e.tr,{children:[(0,r.jsx)(e.td,{children:"\u5f00\u53d1\u73af\u5883"}),(0,r.jsx)(e.td,{children:"ESP-IDF v6.0.2"}),(0,r.jsx)(e.td,{children:"ESP-IDF v5.5.5"})]}),(0,r.jsxs)(e.tr,{children:[(0,r.jsx)(e.td,{children:"\u540e\u53f0"}),(0,r.jsx)(e.td,{children:"xiaozhi.me"}),(0,r.jsx)(e.td,{children:"xiaozhi.me\uff0c\u6216\u672c\u5730 Otto Master"})]})]})]}),"\n",(0,r.jsxs)(e.p,{children:["\u4e24\u79cd\u56fa\u4ef6\u7684\u533a\u522b\u89c1 ",(0,r.jsx)(e.a,{href:"/docs/intro/status",children:"\u529f\u80fd\u72b6\u6001"}),"\u3002"]})]})}function j(t={}){const{wrapper:e}={...(0,n.R)(),...t.components};return e?(0,r.jsx)(e,{...t,children:(0,r.jsx)(x,{...t})}):x(t)}},8453(t,e,s){s.d(e,{R:()=>i,x:()=>c});var d=s(6540);const r={},n=d.createContext(r);function i(t){const e=d.useContext(n);return d.useMemo(function(){return"function"==typeof t?t(e):{...e,...t}},[e,t])}function c(t){let e;return e=t.disableParentContext?"function"==typeof t.components?t.components(r):t.components||r:i(t.components),d.createElement(n.Provider,{value:e},t.children)}}}]);
