lucklyduck/nailongBotWiki/(commit log)

2026-11-03 更新配置文件中的 URL，从本地地址更改为 https://catnipent.cn
2026-11-03 docs: update board references and component kit description
2026-11-03 docs: add downloadable Nailong shell STL
    [nailong-shell.stl]
2026-11-03 docs: link PCB ordering directly to LCEDA
2026-11-12 Add matched purchase links to parts and printing tables
2026-11-12 Host versioned complete print models and unify wiki download guidance
    [01-shell.stl, 02-body-no-arms.stl, 03-right-pin.stl, 04-left-pin.stl, 05-right-leg.stl, 06-left-leg.stl, 07-left-foot.stl, 08-right-foot.stl]
2026-11-13 Replace parts photo shell with yellow STL-based illustration
2026-11-13 Remove model package introduction and assembly video introductory text
2026-11-13 Use concise shell download introduction across assembly pages
2026-11-13 Share material sections between specifications and preparation pages
